ninux/emant/README.md

# emant
Elektromagnetische Felder und Antennen - HSLU T&amp;A
