ninux/emant/lab1/Laborbericht_1_Kusi/tex/title.tex

\begin{titlepage}
	\centering
	% left bottom right top
%	\includegraphics[trim = 20mm 100mm 20mm 20mm, clip, width = 50mm]{pic/title.jpg}\par\vspace{1cm} \nocite{wr}
	
	{\scshape\LARGE Hochschule Luzern \par}
	\vspace{0.75cm}
	{\scshape\Large EMANT Laborbericht 1\par}
	\vspace{1cm}
	{\huge\bfseries Monopol Antenne\par}
	\vspace{1.5cm}
	{\Large\itshape Markus Birrer\par}
	\vspace{0.5cm}
	
	\begin{figure}[htbp]
		\centering
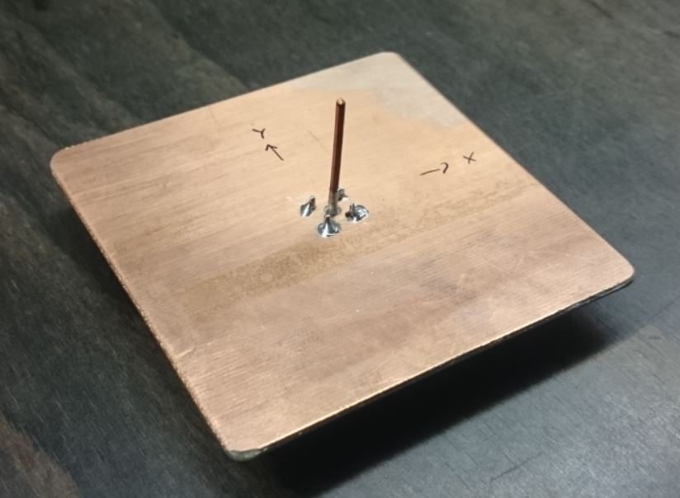
[picture p1: lab1/Laborbericht_1_Kusi/pic/Monopol_Antenne.JPG]
		
		\label{fig:MonopolAntenne}
	\end{figure}
	
		\vspace{0.5cm}
	
	{\Large\itshape Datum Messungen: 4.Mai 2017 \par}

	\vspace*{15 mm}
	\raggedright
	{\Large Selbstständigkeitserklärung} \\
	\vspace{0.5cm}
	Hiermit erkläre ich, dass ich die vorliegende Arbeit selbstständig angefertigt und keine anderen als die angegebenen Hilfsmittel verwendet habe. Sämtliche verwendeten Textauschnitte, Zitate oder Inhalte anderer Verfasser wurden ausdrücklich als solche gekennzeichnet. \\
	\vspace{1cm}
	{\large Horw, \today      \hspace{150pt} Unterschrift:}   

	%supervised by\par
	%Dr.~Mark \textsc{Brown}

	\vfill

% Bottom of the page
%	{\large \today\par}
\end{titlepage}

\newpage
