ninux/emant/lab2/fig/pic/mapping.md

# Mapping - Bild zu Messung

| Name  | Messung |
|---|---|
| d2_01 | blankes PCB mit SMA Stecker, Messkabel und angelötetem USB Stecker |
|  |  |
|  |  |
|  |  |
|  |  |
|  |  |
|  |  |
|  |  |
|  |  |
|  |  |
|  |  |
|  |  |
