ninux/emant/lab2/rep/gls/glossar.tex

\newglossaryentry{g_pwm} {
	name		= {PWM},
	description	= {Pulsweitenmodulation oder Pulsbreitenmodulation
		(engl. \emph{pulse-width modulation}) bezeichnet eine
		Modulationsart mit fester Frequenz und variabler
		Pusldauer}
}

\newglossaryentry{g_ppc} {
	name		= {Gegentaktwandler},
	description	= {Gegentaktwandler oder Gegentaktflusswandler
		(engl. \emph{push-pull converter}) bezeichnet eine
		Schaltung, welche zur Gleichspannungswandlung verwendet wird}
}

\newglossaryentry{g_psr_converter} {
	name		= {Phase-Shift Resonanzwandler},
	description	= {Phase-Shift Resonanzwandler oder Phase-Shift
		PWM Wandler (engl. \emph{phase-shifted full-bridge})
		bezeichnet eine spezielle Implementierung des
		Gegentaktwandlers}
}

\newglossaryentry{g_soft_switching} {
	name		= {weiches Schalten},
	description	= {Weiches Schalten bezeichnet den Schaltvorgang
		von Leistungshalbleitern, welcher durch kleine Schaltverluste
		gekennzeichnet ist}
}

\newglossaryentry{g_hard_switching} {
	name		= {hartes Schalten},
	description	= {Hartes Schalten bezeichnet den Schaltvorgang
		von Leistungshalbleitern, welcher durch hohe Schaltverluste
		gekennzeichnet ist}
}

\newglossaryentry{g_zvs} {
	name		= {Zero-Voltage Switching},
	description	= {Zero-Voltage Switching bezeichnet das
		Schalten von Leistungshalbleitern bei reduziertem
		Spannungabfall über dem Halbleiter. Dieses wird zur
		Reduktion von Schaltverlusten verwendet}
}

\newglossaryentry{g_zcs} {
	name		= {Zero-Current Switching},
	description	= {Zero-Current Switching bezeichnet das
		Schalten von Leistungshalbleitern bei reduziertem
		Strom durch den Halbleiter. Dieses wird zur
		Reduktion von Schaltverlusten verwendet}
}

\newglossaryentry{g_pwm_converter} {
	name		= {PWM Wandler},
	description	= {PWM Wandler oder auch PWM Gegentaktwandler
		bezeichnet einen Gleichspannungswandler, welcher die
		Pulsweitenmodulation verwendet}
}

\newglossaryentry{g_tina} {
	name		= {TINA},
	description	= {PSpice gestütztes Programm zur
		Schaltungssimulation von DesignSoft}
}

\newglossaryentry{g_matlab} {
	name		= {MATLAB},
	description	= {Programmiersprache und gleichnamies Programm
		zur numerischen Berechnung und Simulation von
		MathWorks}
}

\newglossaryentry{g_duty} {
	name		= {Tastgrad},
	description	= {Als Tastgrad (engl. \emph{duty-cycle}) wird die
		Aussteuerung bzw. der Modulationsgrad von
		verschiednenen Wandlungs- oder Modulationsverfahren
		bezeichnet}
}

\newglossaryentry{g_zk} {
	name		= {Zwischenkreis},
	description	= {Als Zwischenkreis bezeichnet man in der
		Leistungselektronik Energiespeicher, welche verschiedene
		Netze koppeln}
}

\newglossaryentry{g_wav} {
	name		= {Waveform Datei},
	description	= {Aus RIFF abgeleitetes Dateiformat für die
		Datenspeicherung (meist Audiodaten)}
}
