ninux/emant/lab2/rep/pkg/definitions.tex

% define plot parameters
\newcommand{\twopltvmin}{10.5}
\newcommand{\twopltvmax}{13.5}
\newcommand{\twopltcrmin}{0.00}
\newcommand{\twopltcrmax}{1.20}
\newcommand{\twopltsocmin}{-5}
\newcommand{\twopltsocmax}{105}
\newcommand{\twopltdvmin}{0.05}
\newcommand{\twopltdvmax}{0.65}

% define schematic parametery
\newcommand{\schematicscale}{0.5}
