ninux/emant/lab2/rep/tex/discussion/discussion.tex

\section{Fazit $\&$ Diskussion}
Der Vergleich zwischen Simulationen und Messungen zeigten Übereinstimmungen. Wir waren in der Lage eine Antenne zu entwickeln und zu bauen, welche die gewünschten Anforderungen erfüllt. Das besonders gute Ergebnis beim Reflexionskoeffizient bei 2.4 GHz war ein Glücksfall.
