ninux/emant/lab2/rep/tex/title/title.tex

\thispagestyle{empty}
\begin{titlepage}

\begin{center}

% Oberer Teil der Titelseite:
%\includegraphics[width=0.15\textwidth]{./logo}\\[1cm]    
\textsc{
	\LARGE Hochschule Luzern\\~\\Technik \& Architektur}\\[1.5cm]
\vfill{}
\large EMANT
\\[0.5cm]
% Title
\newcommand{\HRule}{\rule{\linewidth}{0.5mm}}
\HRule
\\[0.4cm]
{
	%\Huge \bfseries Industrieprojekt\\
        %~\\
        %\large Aufbau eines 800W Phase-Shift Resonanzwandlers}\\[0.4cm]

	\Huge \bfseries Design Report Laborübung 2\\
        ~\\
        \large Entwicklung einer WLAN\texttrademark  Planarantenne}
\\[0.4cm]
\HRule
\\[0.5cm]

%	\large zur Erlangung des Testats \\
%		zur Modulendprüfung des Moduls \\
%		Elektromagnetische Felder und Antennen

\vfill{}

% Author and supervisor
\begin{minipage}{0.4\textwidth}
    \begin{flushleft} \large
	\emph{Autoren}\\
        Ervin Mazlagi\'c\\
        Markus Birrer\\ ~ \\
	\emph{Eingabe der Arbeit}\\
	Horw, \today
    \end{flushleft}
\end{minipage}
\hfill
\begin{minipage}{0.4\textwidth}
    \begin{flushright} \large
        \emph{Dozent} \\
        Joss Marcel
    \end{flushright}
\end{minipage}

%\vfill{}

% Unterer Teil der Seite
%{
%	%\large Altishofen\\ \today
%	Horw\\ 23. Dezember 2016
%}

%\begin{minipage}{0.4\textwidth}
%	\begin{flushleft}
%		\emph{Geheimhaltungsstufe}
%		Rücksprache
%	\end{flushleft}
%\end{minipage}
%\hfill
%\begin{minipage}{0.4\textwidth}
%	\begin{flushright}
%		Horw\\ 23. Dezember 2016
%	\end{flushright}
%\end{minipage}

\end{center}

\end{titlepage}
