ninux/emant/lab2/rep/tex/README.md

# tex - LaTeX Dokumente
---

* Titelseite			(title/title.tex)
* Selbstständigkeitserklärung	(declaration/declaration.tex)
* Abstract			(abstract/abstract.tex)
* Inhaltsverzeichnis		(-)
* Glossar			(glossary/glossary.tex)

## Teil I - Einführung		(introduction/)
* Applikation			(application.tex)
* Problemstellung		(problem.tex)
* Aufgabenstellung		(mission.tex)

## Teil II - Theorie		(theory/)
* Verluste von MOSFET-Schaltern (losses.tex)
* Phasenverschiebungsmodulation (psm.tex)

## Teil III - Simulation	(simulation/)
* Simulationsmodelle		(models.tex)
* Messungen			(measurements.tex)
* Modulator			(modulator.tex)
* Ergebnisse			(results.tex)

## Teil III - Funktionsmuster	(experimental/)	
* Controller Evaluation		(evaluation.tex)
* Simulation			(simulation.tex)
* Funktionsmuster		(model.tex)
* Ergebnisse			(results.tex)

## Teil IV - Prototyp		(prototype/)

## Teil V - Vergleich		(comparison/)

## Listen & Anhänge	
* Literaturverzeichnis		(-)
* Abbildungsverzeichnis		(-)
* Tabellenverzeichnis		(-)
* Anhang			(appendix/appendix.tex)
