ninux/emant/lab1/Laborbericht_1_Kusi/main.tex

\documentclass[a4paper,10pt,fleqn]{article}
\usepackage{tex/layout}

\usepackage{hyperref}
\usepackage{url}

\begin{document}

\input{tex/title}

\newpage
%\input{tex/Selbststaendigkeitserklaerung}

% Inhaltsverzeichniss
\input{tex/table}

%\input{tex/aufgabenstellung}
\input{tex/text}

\vspace{30mm}
% \phantomsection
%\addcontentsline{toc}{section}{\listfigurename}
\listoffigures

%\newpage
%\bibliographystyle{plain}
%\bibliography{tex/bibliographie}
%\nocite{dsvb_script}
\nocite{*}
       
\end{document}
