ninux/emant/lab2/rep/tex/calculation/calculation.tex

\section{Berechnungen}

\begin{figure}[h!]
	\centering
	
	\caption{Link-Budget und weitere Berechnungen}
\end{figure}
