ninux/emant/lab1/Laborbericht_1_Kusi/Sonstige Doks/Analyse Bilder.pptx

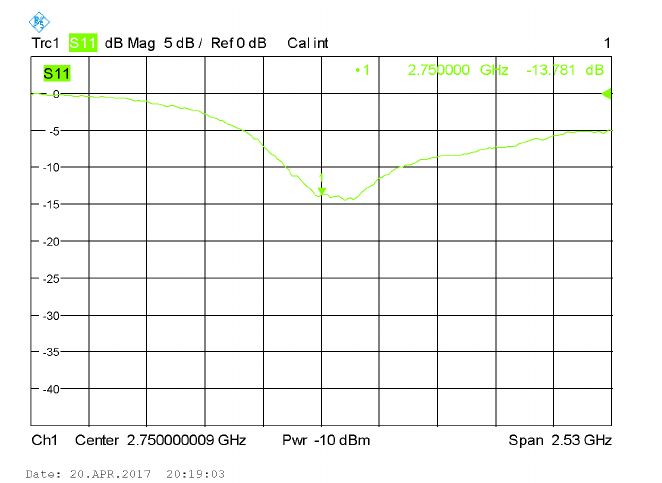
[picture p32: figure]

2.5GHz

3GHz

2.875GHz
