ninux/emant/lab1/Laborbericht_1_Kusi/Laborbericht _1_Markus_Birrer.pdf

Hochschule Luzern

EMANT Laborbericht 1

# Monopol Antenne

## Markus Birrer

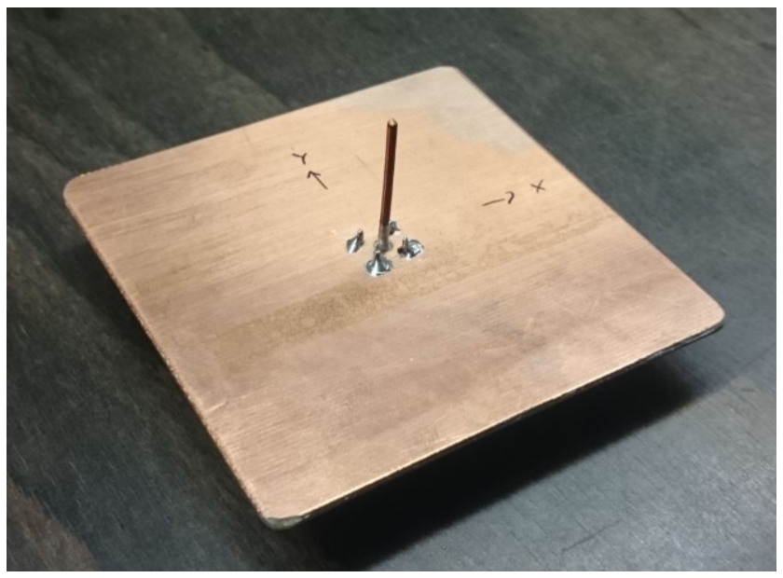
[picture p33: figure]

## Datum Messungen: 4.Mai 2017

## Selbstständigkeitserklärung

Hiermit erkläre ich, dass ich die vorliegende Arbeit selbstständig angefertigt und keine anderen als die angegebenen Hilfsmittel verwendet habe. Sämtliche verwendeten Textauschnitte, Zitate oder Inhalte anderer Verfasser wurden ausdrücklich als solche gekennzeichnet.

Horw, 19. Mai 2017 | Unterschrift:

EMANT | Hochschule Luzern - Technik & Architektur | Markus Birrer

## Inhaltsverzeichnis

1 Zusammenfassung | | 1
2 Einführung | | 2
3 Experimentelles | 3
4 Resultate | 7
5 Diskussion/Analyse | 9

## 1 Zusammenfassung

Dieser Bericht behandelt das Entwickeln, Simulieren und Ausmessen einer Monopolantenne. Zweck der Aufgabenstellung war Erfahrungen in der Handhabung der verschiedenen Tools zu gewinnen. Dazu gehört die Simulationssoftware EMPIRE, das Kalibrieren und Messen mit dem Netzwerkanalyser und das Ausmessen mit dem Linear Scanner.
Die Designfrequenz der Monopolantenne beträgt 2.75 GHz. Mittels der Simulationsoftware EMPIRE wurde das mechanische Design so verändert, dass die Parameter die gewünschten Anforderungen erfüllen. Insbesondere der Reflexionskoeffizient S11 sollte bei der Designfrequenz einen möglichst tiefen Wert erreichen.
Nach der Produktion wurde die Antenne als erstes mit dem Netzwerkanalyzer ausgemessen. Die Antenne zeigte ansatzweise das gewünschte Verhalten. Die effektive Resonanzfrequenz lag leicht höher als die Designfrequenz Der Reflexionskoeffizient S11 war nicht ganz so ausgeprägt wie simuliert. Durch mechanische Bearbeitung (abschneiden) konnte die Resonanzfreqquenz der Designfrequenz angenähert werden.
Zum Abschluss wurde noch die Abstrahlcharakteristik der Antenne ausgemessen. Dabei zeigte die Antenne das erwartete Verhalten in der Form eines Apfels.
19. Mai 2017 | 1

EMANT | Hochschule Luzern - Technik & Architektur | Markus Birrer

## 2 Einführung

### 2.1 Designfrequenz

Es wurde eine Designfrequenz von 2.75GHz gewählt.

### 2.2 Berechnungen

Die Designfrequenz war die Basis für Berechnungen zur Länge der Monopolantenne und zur Grösse der Platine. Diese Werte wurden Mithilfe von Excel berechnet:

Wellenlänge:

λ =

c
f = 109 mm

λ
4 = 27.2 mm

Aussenmasse der Platine: Bei den Aussenmassen der Platine ist ein Fehler unterlaufen. Gemäss Aufgabenstellung sollte die Diagonale der GND-Plane √

λ
2

betragen. Dies entspricht bei der gewählten Designfrequenz 77 mm. Aus Versehen wurde eine Kantenlänge von 77 mm gewählt.

### 2.3 Koordinatensystem

Um sich besser zurechtzufinden, ist hier nochmals das Koordnatensystem mit den Winkel abgebildet. [Joss.M, 2017, Elektromagnetische Felder und Antennen, Seite 8]


Abbildung 1: Koordinatensysteme

19. Mai 2017 | 2

EMANT | Hochschule Luzern - Technik & Architektur | Markus Birrer

## 3 Experimentelles

### 3.1 Verwendete Messgeräte

Messgerät | Hersteller | Inventarnr.
Netzwerkanalyzer | Rohde & Schwarz | 342
Linear Scanner | Starlab | ??

Tabelle 1: Liste mit den verwendeten Messgeräten

### 3.2 Simulation

### 3.2.1 Vorbereitung zur Simulation

Vor der eigentlichen Simulation wurde die Monopolantenne im Simulationstool gezeichnet. Die Monopolantenne besteht aus den drei Komponenten:

- Groundplane
- Monopol
- Source

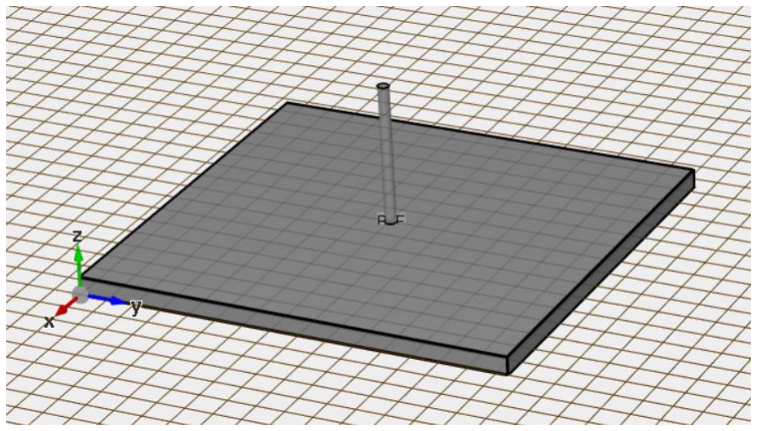
[picture p34: figure]

Abbildung 2: 3D-Darstellung der Platine

19. Mai 2017 | 3

EMANT | Hochschule Luzern - Technik & Architektur | Markus Birrer

### 3.2.2 Simulationsergebnisse

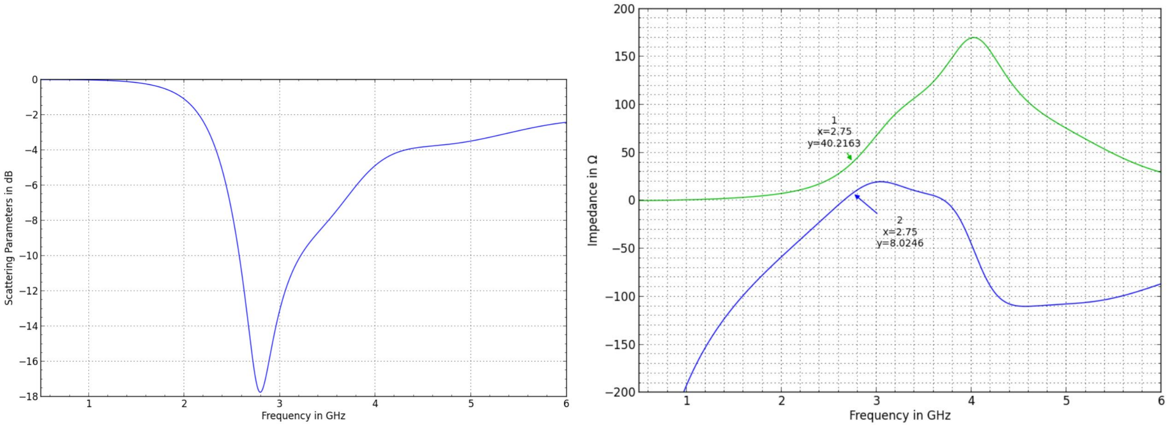
[picture p35: figure]

(a) Reflexionskoeffizient S11 | (b) Impedanz Z (grün: Real(Z), blau: Imag (Z)

Abbildung 3: Simulation der Parameter

Auf Abbildung 3a ist ersichtlich, dass der tiefste Reflexionskoeffizient des Designs bei ca. 2.8 GHz liegt. Abbildung 3b zeigt den Realanteil und Imaginäranteil der Impedanz bei der Designfrequenz von 2.75GHz. Der Realanteil beträgt ca. 40 Ω statt den gewünschten 50 Ω. Der Imaginäranteil beträgt 8 Ω statt 0 Ω. Mit der Kenntnis der entstehenden Impedanz könnte das Design optimiert werden. Dies war in der Aufgabenstellung nicht gefordert und wurde dementsprechend unterlassen.

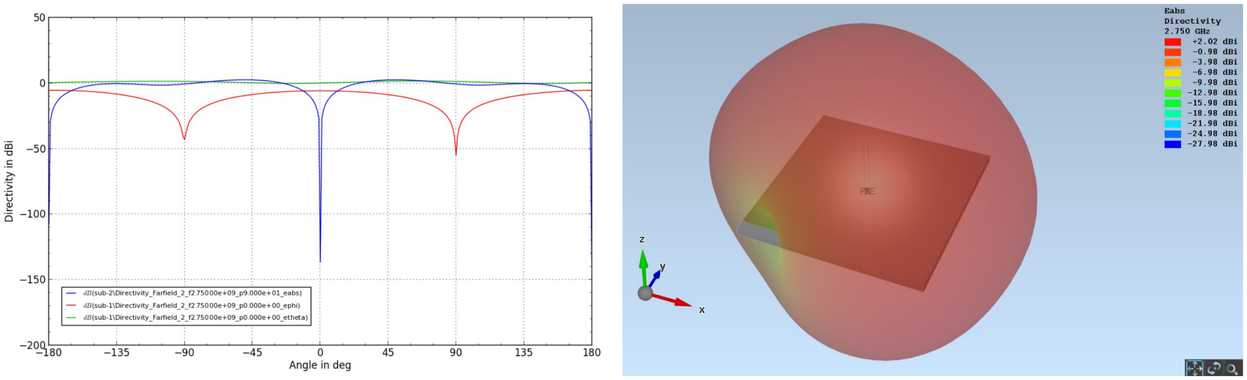
[picture p36: figure]

(a) Fernfeld im Diagramm | (b) Fernfeld graphisch

Abbildung 4: Fernfeld-Simulationen

Abbildung 4 zeigt die graphische Simulation des Fernfeldes. Die dargestellte Grafik zeigt nicht das gewünschte Verhalten. Die Punkte mit schwachem Feld sollten oberhalb und unterhalb des Monopols liegen. Stattdessen liegen sie in der horizontalen Ebene. Die Ursache für die fehlerhafte Darstellung konnte nicht gefunden werden. Sehr wahrscheinlich liegt es an einer inkorrekten Einstellung im Simulationsprogramm.

19. Mai 2017 | 4

EMANT | Hochschule Luzern - Technik & Architektur | Markus Birrer

### 3.3 Versuchsablauf

Nachfolgend ist beschrieben wie die Messungen durchgeführt werden.

### 3.3.1 Netzwerkanalyser

Kalibrierung Vor der eigentlichen Messung gilt es den Netzwerkanalyser zu kalibrieren. Dafür gibt es spezielle Messwiderstände. Im Umgang mit den Koaxialkabeln gilt es zu beachten, dass diese möglichst wenig gebogen werden. Auch müssen die Kabel mit einem bestimmten Drehmoment angeschlossen werden. Dazu steht ein spezieller Drehmomentschlüssel zur Verfügung. Das Kabel und die Widerstände sollen so platziert werden, dass sie eine gewisse Distanz zu anderen Gegenständen aufweisen.
Der Netzwerkanalyser verfügt über ein Menü (Taste CAL), welches den Anwender durch den Kalibrierungsprozess führt.

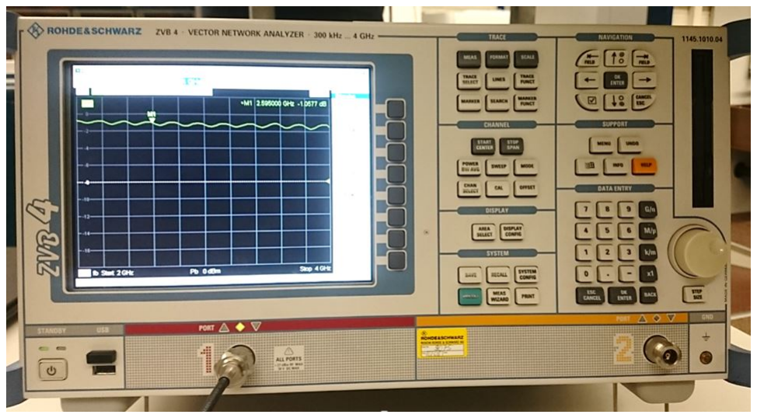
[picture p37: figure]

Abbildung 5: Netzwerkanalyzer

Return-Loss-Messung
Nach dem Kalibrieren geht es darum die eigentliche Messung durchzuführen. Dazu wird die Monopolantenne ans Kabel angeschlossen. Über die Tasten PRES, MEAS gelangt man in das richtige Menü. Es handelt sich um eine Return-Loss Messung (S11). Bevor das/die Bilder der Messung exportiert werden, empfiehlt es sich einen oder mehrere Marker zu setzen.
19. Mai 2017 | 5

EMANT | Hochschule Luzern - Technik & Architektur | Markus Birrer

### 3.3.2 Linear Scanner

Mit dem Linear Scanner von StarLab kann die Richtstrahlcharakteristik von Antennen bestimmt werden. Es ist empfohlen vor dem Montieren des Testprints die Achsen zu markieren (Beispiel; siehe Titelbild). Wenn man vor dem Starlab steht, zeigt die x-Achse nach rechts und die y-Achse nach hinten (ins Gerät hinein). Nach dem Montieren des Testprints kann die Messöffnung mit den beiden mobilen Stellwänden verschlossen werden.


Abbildung 6: Linear Scanner von Starlab

Auf dem BedienPC werden zwei Programme benötigt. Zum einen das Programm SPM, mit welchem die eigentliche Messung durchgeführt wird. Zum anderen das Programm SatEnv, welches die Datenauswertung vornimmt. Nach der Messung können die Daten vom SPM in ein neues Projekt des SatEnv exportiert werden. Betreffend dem Vorgehen der Datenauswertung im SatEnv liegt eine detaillierte Bedienungsanleitung vor.

19. Mai 2017 | 6

EMANT | Hochschule Luzern - Technik & Architektur | Markus Birrer

## 4 Resultate

### 4.1 Messung mit dem Netzwerkanalyser

Bei der Messung des Reflektionskoeffizienten (S11) wurde der tiefste Wert bei einer Frequenz unterhalb von der Designfrequenz 2.75 GHz erreicht. Durch manuelles Verkürzen des Monopols in mehreren Schritten konnte die Frequenz erhöht werden. Es wurde schlussendlich ein bisschen zu viel abgeschnitten, die Antenne ist ein bisschen zu kurz geraten. Die geringste Reflexion wird bei ca. 2.875 GHz erreicht.
Der S11-Wert von -13.8dB ist nicht enorm gut, aber doch respektabel für einen ersten Entwurf.


Abbildung 7: Messung des Reflexionskoeffizienten S11

19. Mai 2017 | 7

EMANT | Hochschule Luzern - Technik & Architektur | Markus Birrer

### 4.2 Messung mit dem Linearscanner

Es wurde die Messung bei der Frequenz von 2.85 GHz ausgewertet. Dies weil die Messung mit dem Netzwerkanalyzer bei dieser Frequenz den geringsten Reflektionsfaktor zeigte.
Das Resultat entspricht den Erwartungen. Die 3D-Grafik zeigt eine ”apfelförmige” Abstrahlcharakteristik.

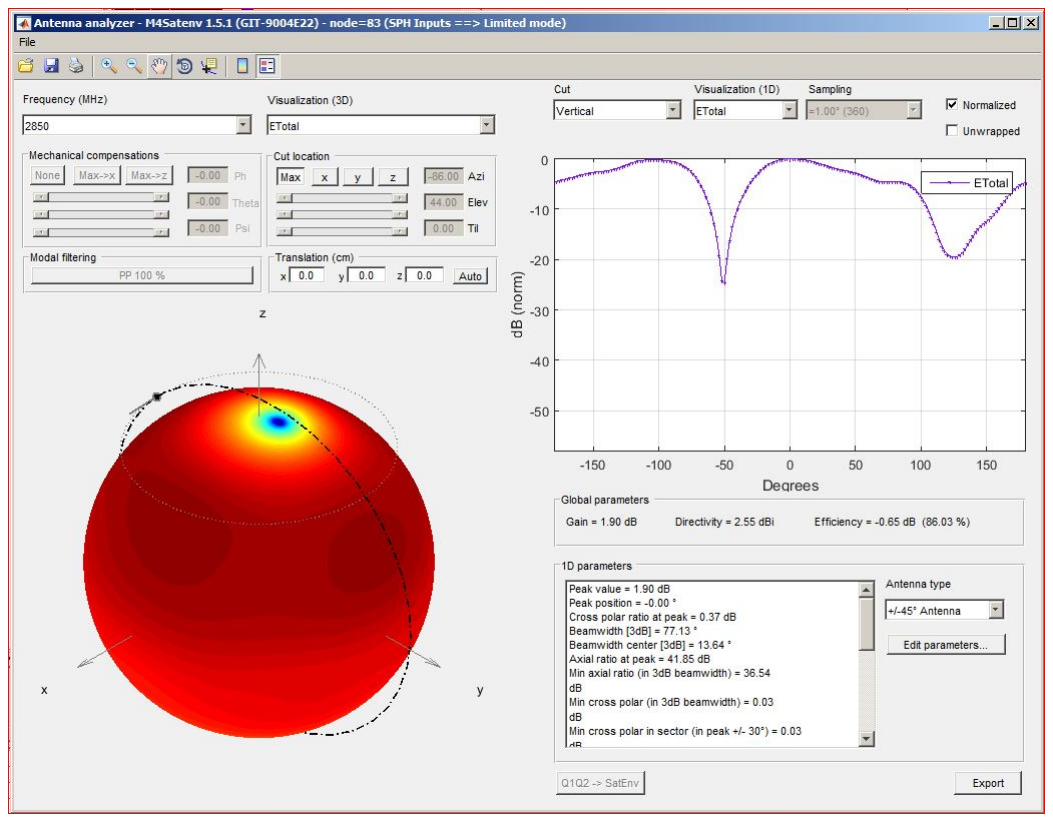
[picture p38: figure]

(a) Fernfeld geschnitten in der xz-Ebene (φ = 0°) | (b) Fernfeld graphisch

Abbildung 8: Fernfeld Messungen

Der maximale Antennengewinn beträgt 1.9dB beim Punkt mit den Winkeln φ = 0° und θ ca. 45°

19. Mai 2017 | 8

EMANT | Hochschule Luzern - Technik & Architektur | Markus Birrer

## 5 Diskussion/Analyse

Es konnte eine Monopol-Antenne produziert werden, welche das klassische Verhalten einer Monopol-Antenne zeigt. Die Performance der Antenne ist nicht sonderlich gut, aber liegt in der Toleranz für einen ersten Entwurf. Die Schwierigkeiten lagen in der Bedienung der Simulationssoftware EMPIRE und der Datenauswertung im Starlab. Gerade im Starlab steht man unter Zeitdruck, da nur Messgerät zur Verfügung steht.
Trotz der Schwierigkeiten, konnten Erfahrungen im Umgang mit der Simulationssoftware und den Messgeräten gesammelt werden.

## Abbildungsverzeichnis

1 | Koordinatensysteme | | 2
2 | 3D-Darstellung der Platine | | 3
3 | Simulation der Parameter | | 4
4 | Fernfeld-Simulationen | | 4
5 | Netzwerkanalyzer | | 5
6 | Linear Scanner von Starlab | | 6
7 | Messung des Reflexionskoeffizienten S11 | | 7
8 | Fernfeld Messungen | | 8
19. Mai 2017 | 9
