ninux/emant/lab1/Laborbericht_1_Kusi/pic/Messungen/Rigi Hochflue.JPG

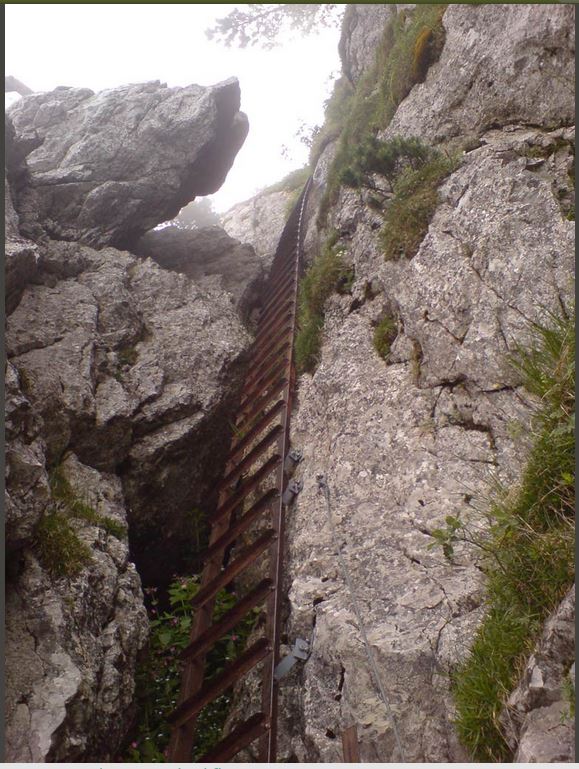
lab1/Laborbericht_1_Kusi/pic/Messungen/Rigi Hochflue.JPG
