ninux/emant/lab1/Laborbericht_1_Kusi/Sonstige Doks/DSC_1302.JPG

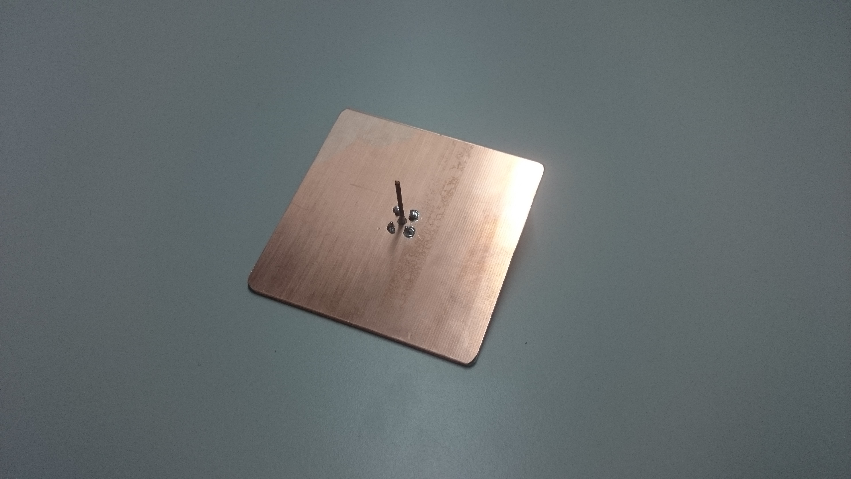
lab1/Laborbericht_1_Kusi/Sonstige Doks/DSC_1302.JPG
