ninux/emant/lab1/Laborbericht_1_Kusi/Sonstige Doks/DSC_1329.JPG

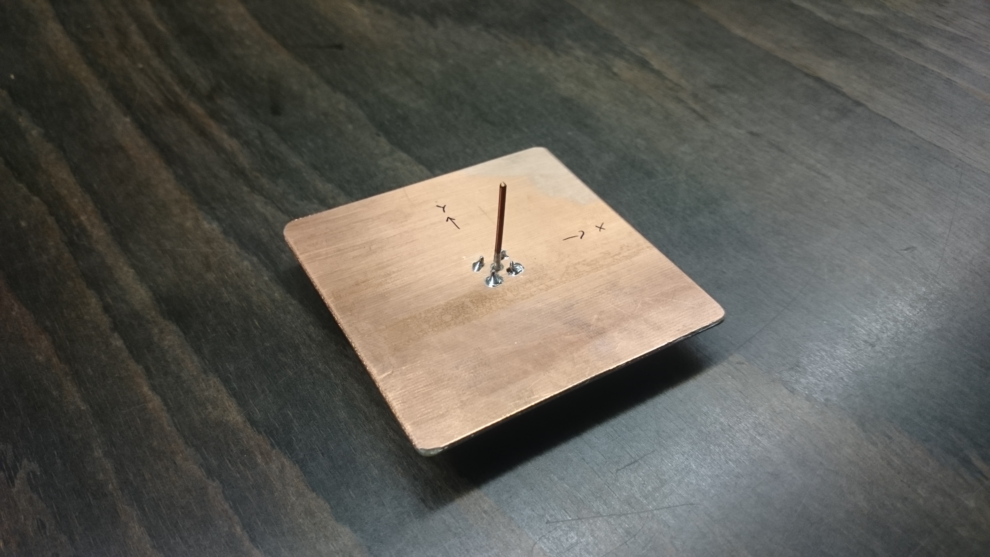
lab1/Laborbericht_1_Kusi/Sonstige Doks/DSC_1329.JPG
