ninux/emant/lab1/Laborbericht_1_Kusi/Sonstige Doks/Messung_S11.PNG

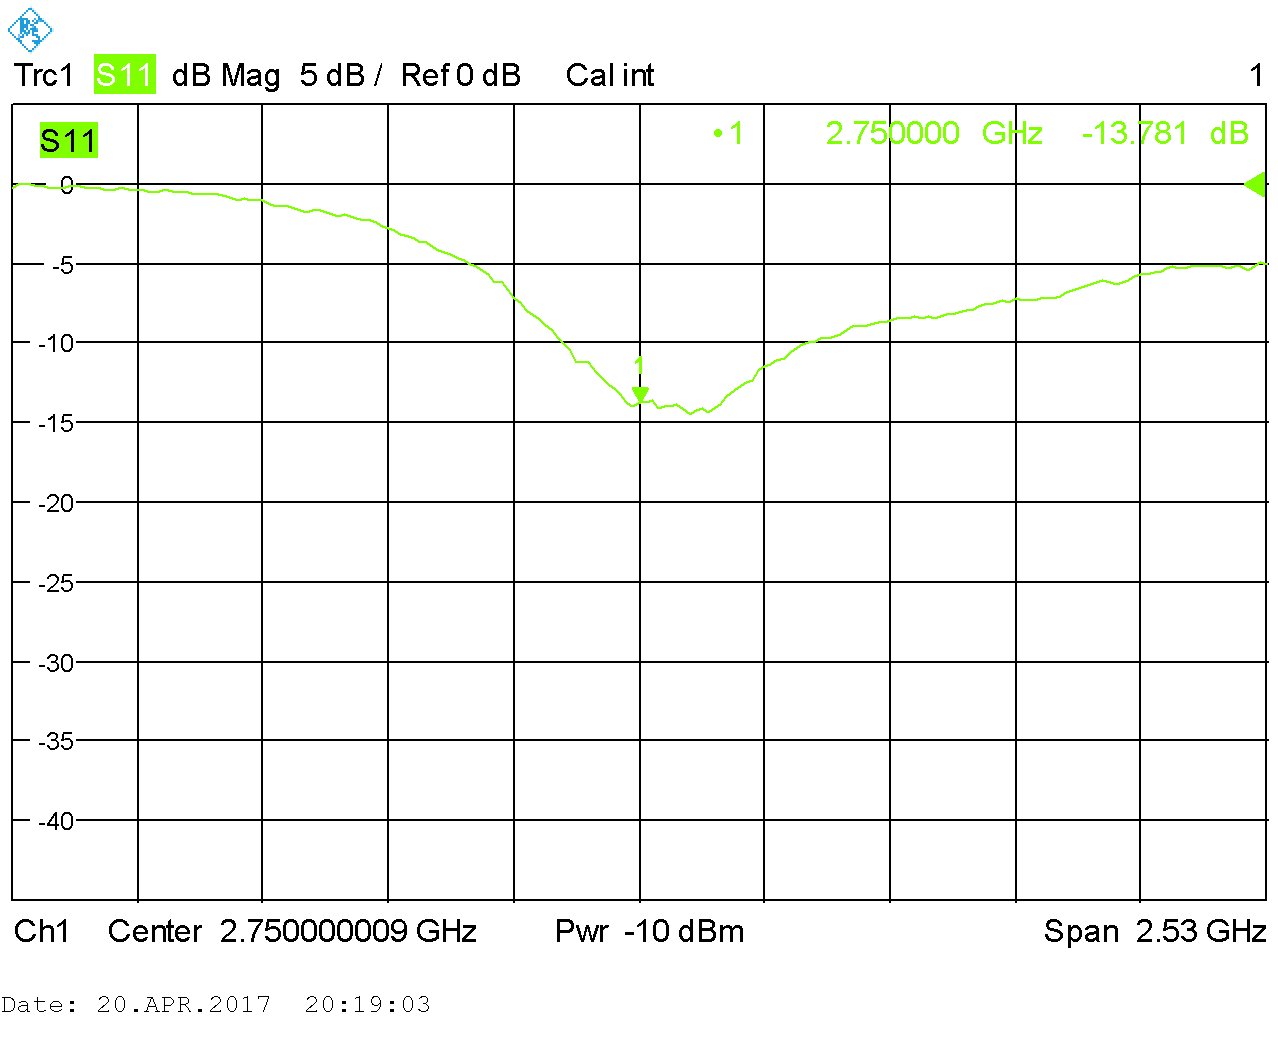
lab1/Laborbericht_1_Kusi/Sonstige Doks/Messung_S11.PNG
