ninux/emant/lab1/ninux/fig/plt/monopol_a_sim_3d_ephi.png

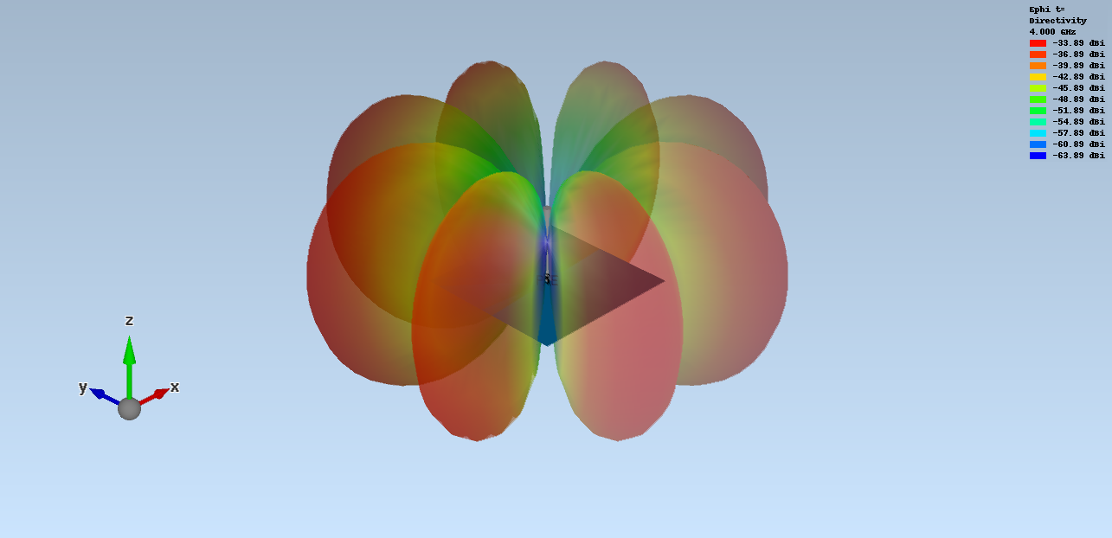
lab1/ninux/fig/plt/monopol_a_sim_3d_ephi.png
