ninux/emant/lab1/ninux/fig/plt/monopol_a_sim_3d_etheta.png

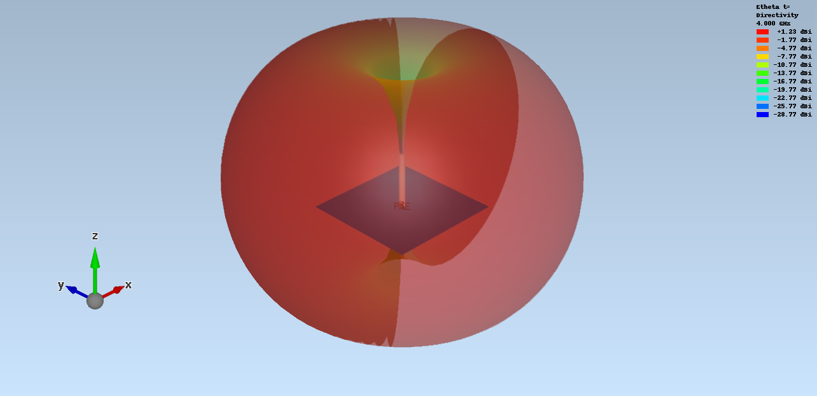
lab1/ninux/fig/plt/monopol_a_sim_3d_etheta.png
