ninux/emant/lab1/ninux/fig/plt/monopol_a_sim_3d_pattern.png

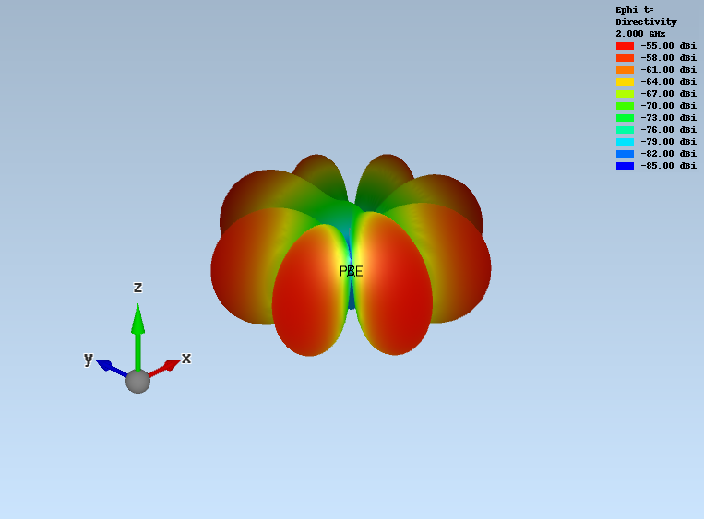
lab1/ninux/fig/plt/monopol_a_sim_3d_pattern.png
