ninux/emant/lab2/bilder_StarLab/StarLab_Etot/2.4GHz_sphere.JPG

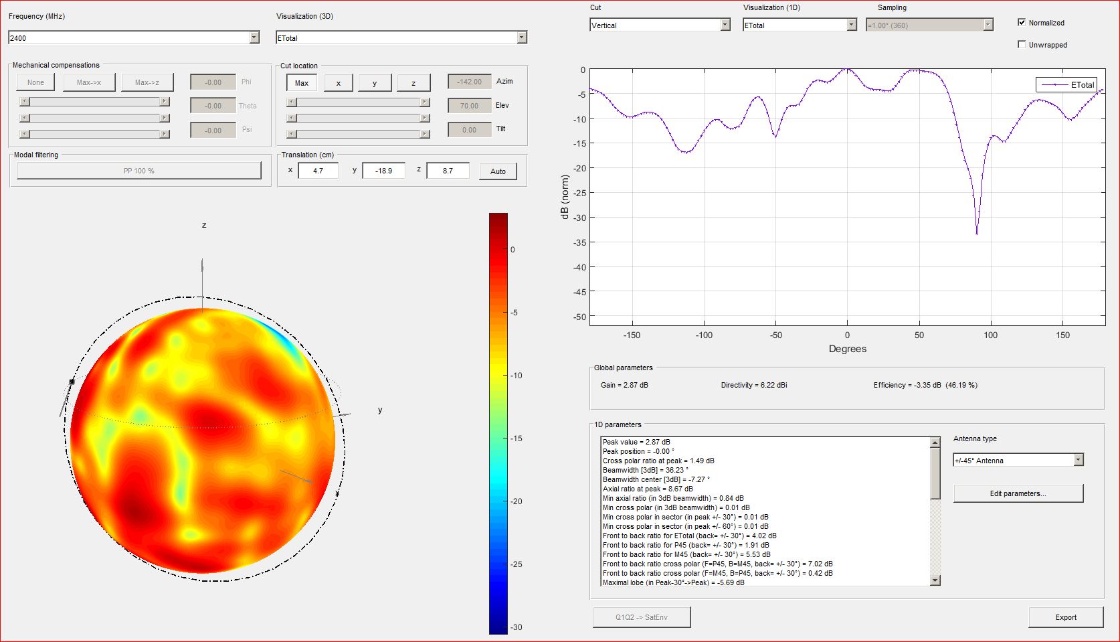
lab2/bilder_StarLab/StarLab_Etot/2.4GHz_sphere.JPG
