ninux/emant/lab2/bilder_StarLab/StarLab_Etot/2.4GHz_sphere_xz.JPG

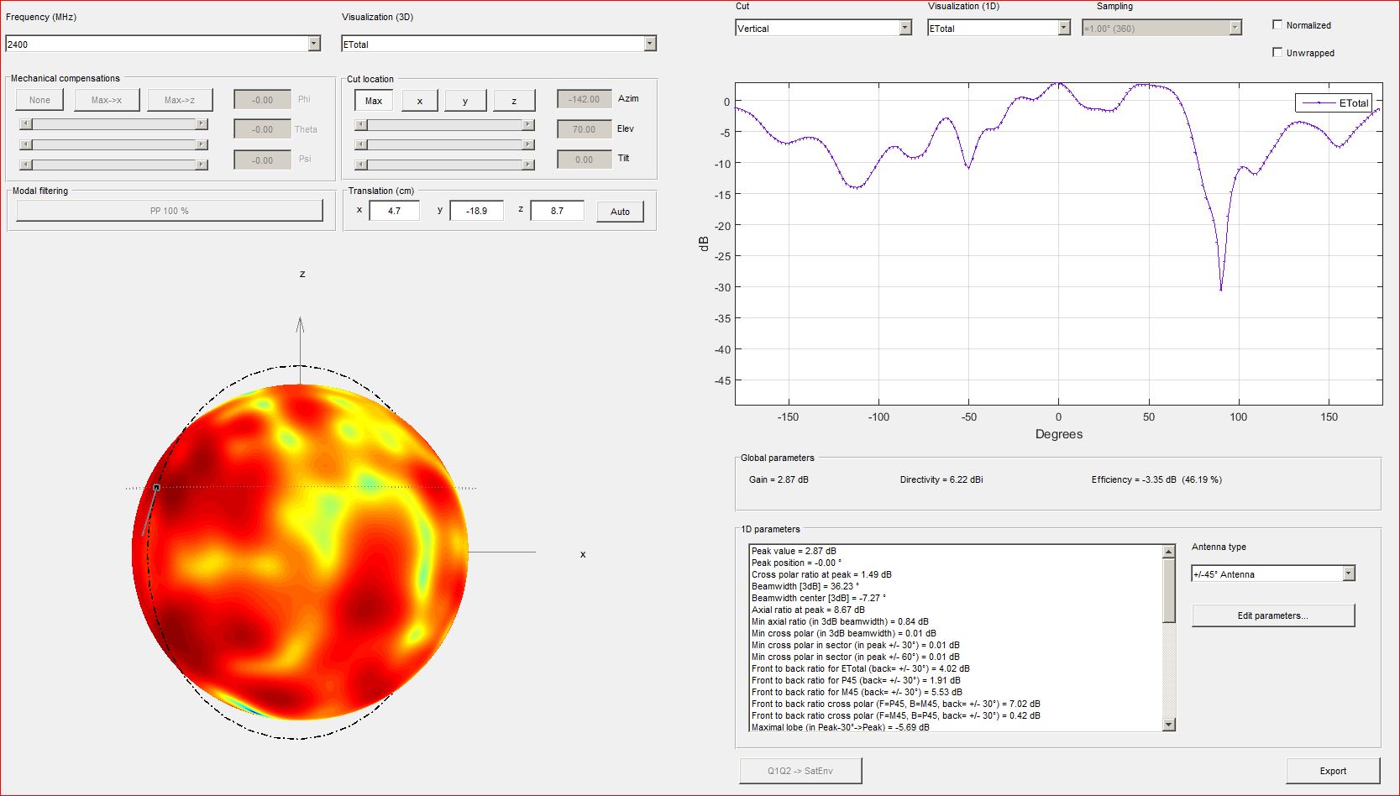
lab2/bilder_StarLab/StarLab_Etot/2.4GHz_sphere_xz.JPG
