ninux/emant/lab2/bilder_StarLab/StarLab_Etot/5GHz_sphere_xz.JPG

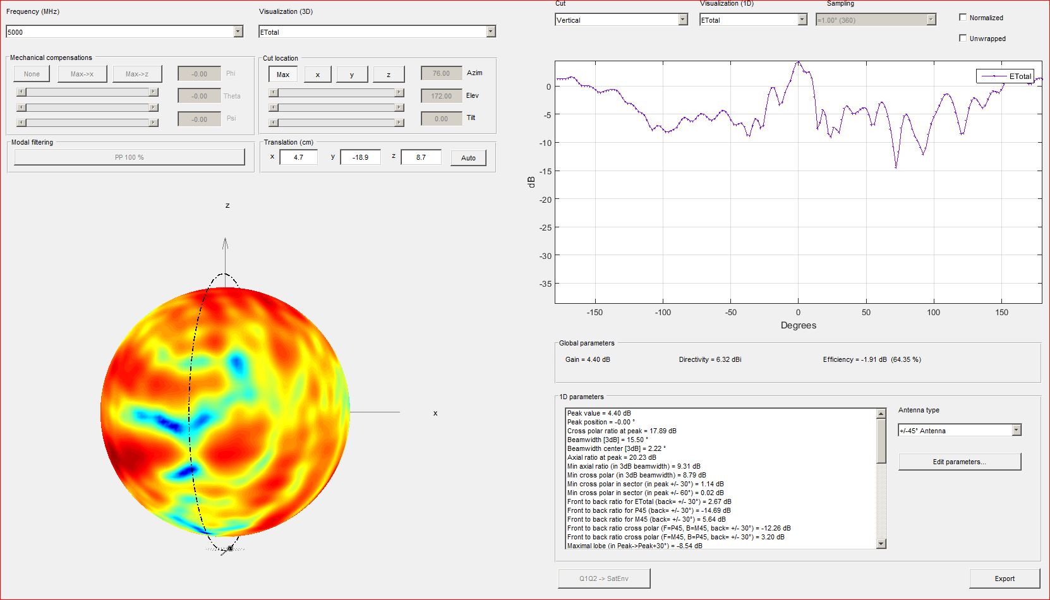
lab2/bilder_StarLab/StarLab_Etot/5GHz_sphere_xz.JPG
