ninux/emant/lab2/fig/not_used/crazy_stuff_l4_pcb_v2c_laptop_1a_105_2_4G_etot_phi90_1D.png

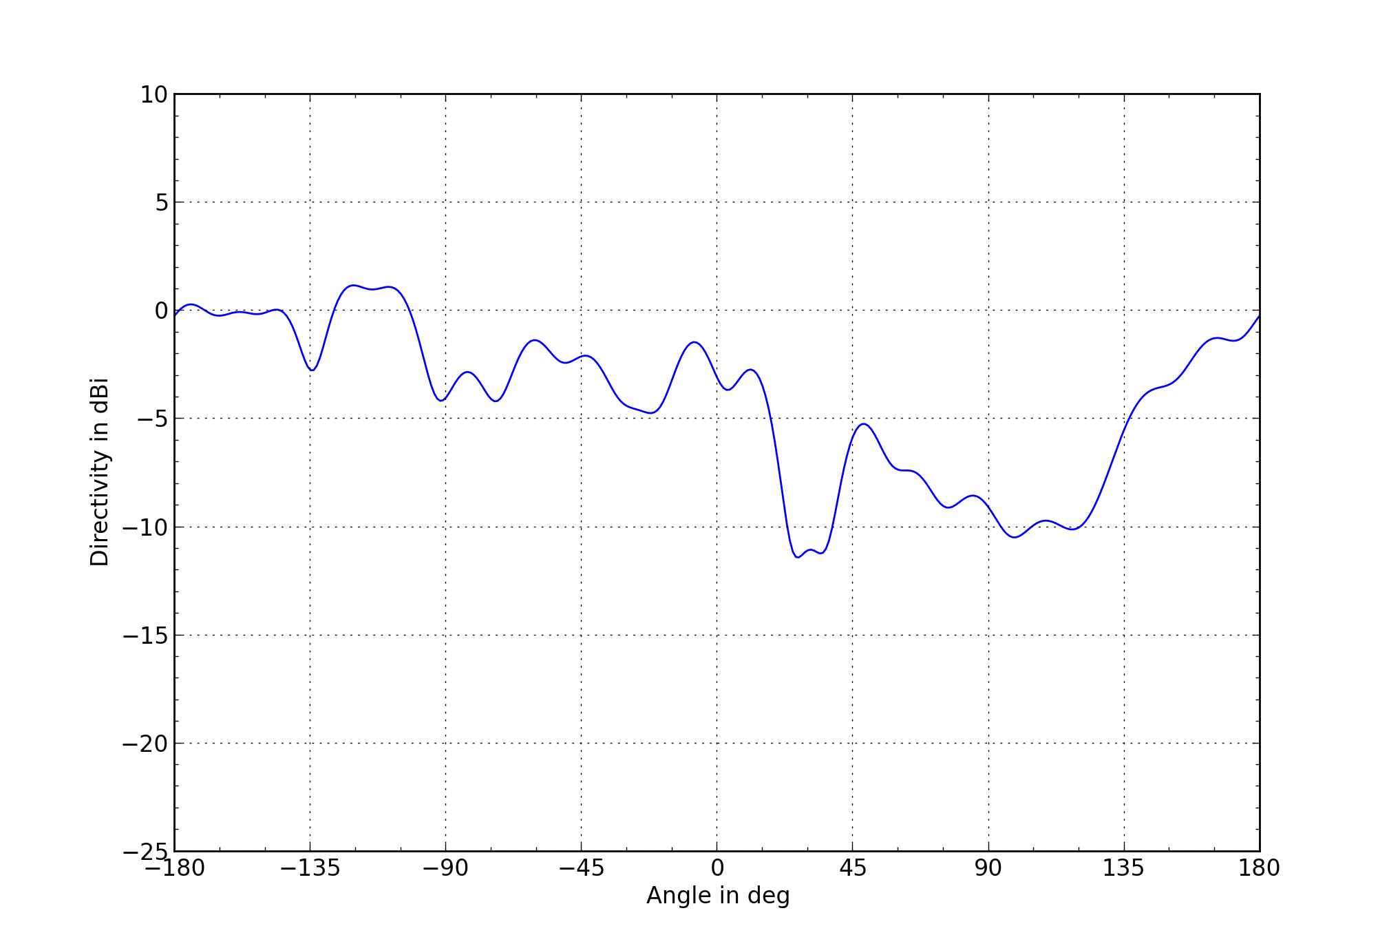
lab2/fig/not_used/crazy_stuff_l4_pcb_v2c_laptop_1a_105_2_4G_etot_phi90_1D.png
