ninux/emant/lab2/fig/not_used/crazy_stuff_l4_pcb_v2c_laptop_1a_105_2ghz4_3d_current_density_xy.png

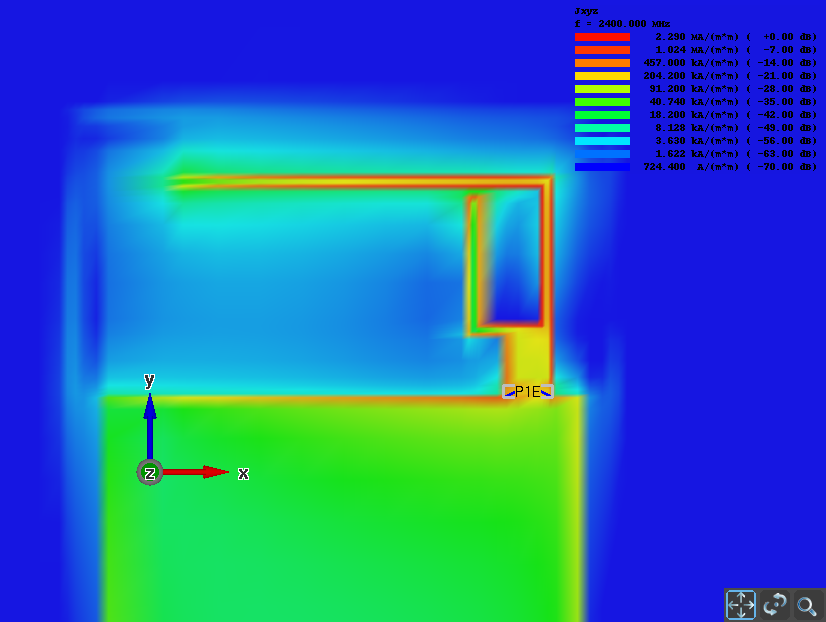
lab2/fig/not_used/crazy_stuff_l4_pcb_v2c_laptop_1a_105_2ghz4_3d_current_density_xy.png
