ninux/emant/lab2/fig/not_used/IMP_WITHOUT_2.4.PNG

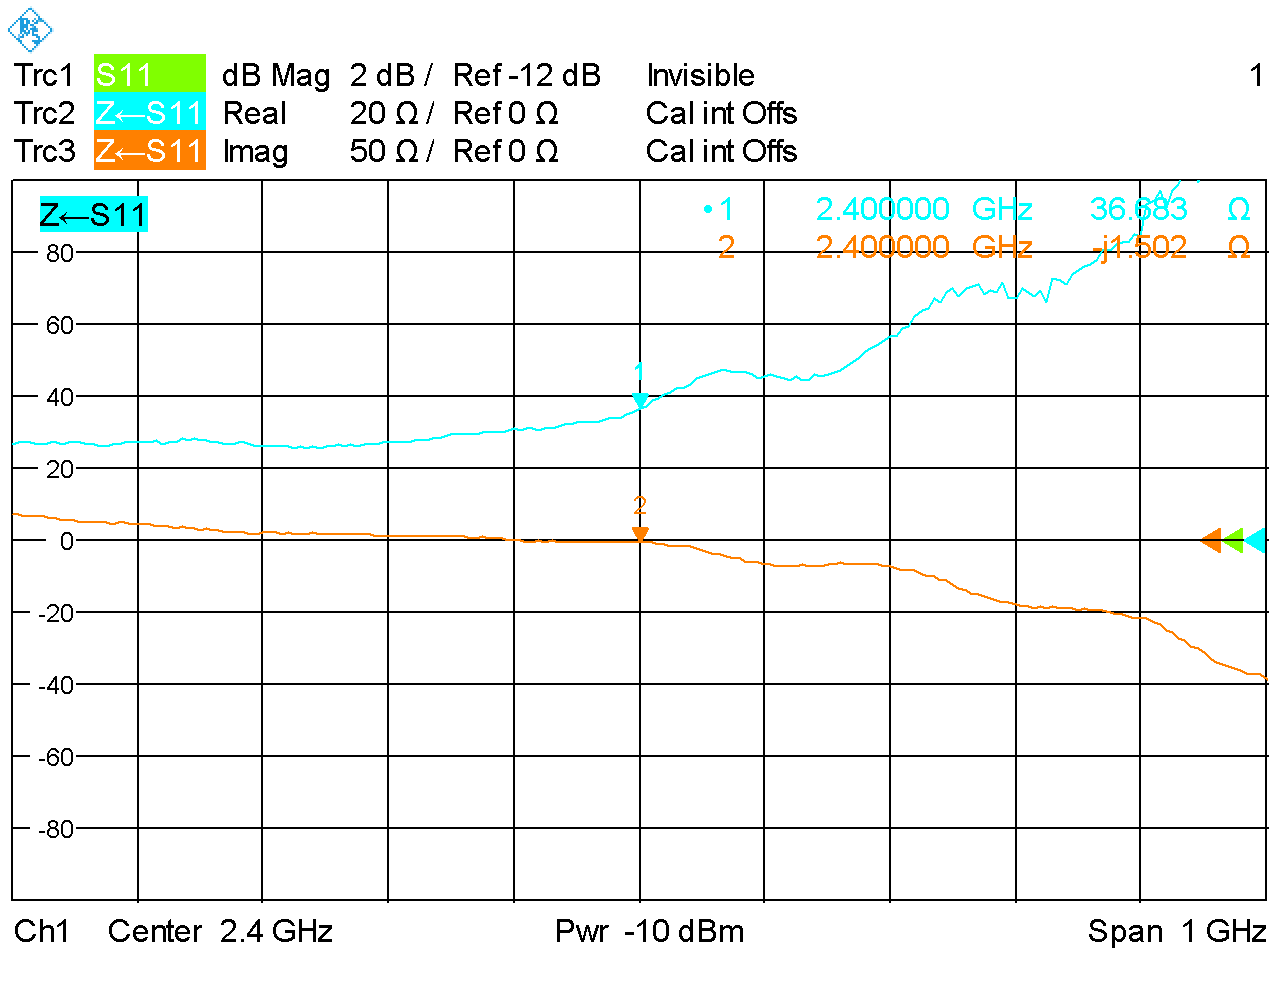
lab2/fig/not_used/IMP_WITHOUT_2.4.PNG
