ninux/emant/lab2/fig/not_used/IMP_WITHOUT_5.0.PNG

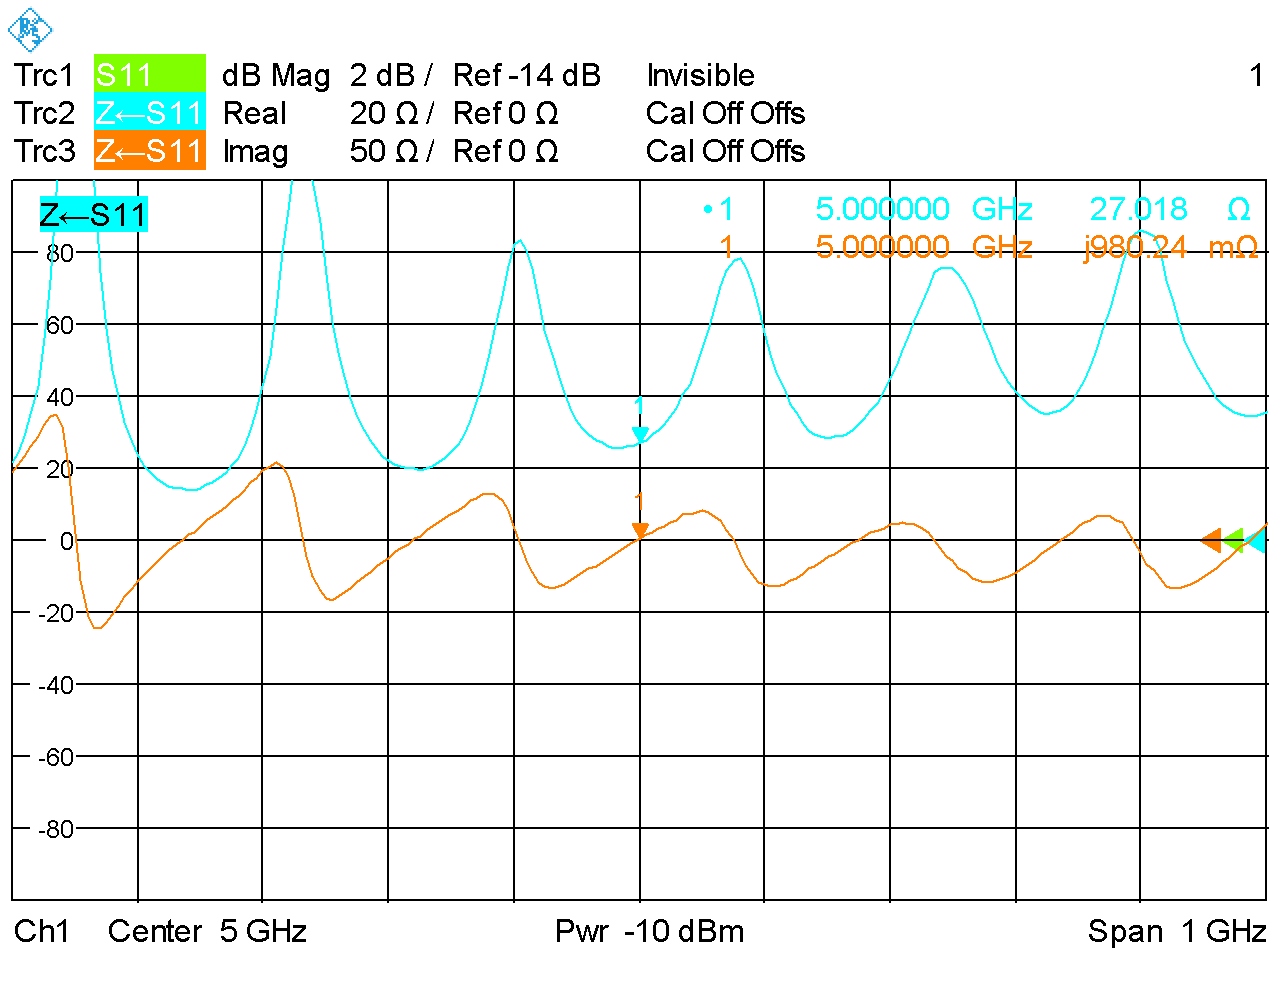
lab2/fig/not_used/IMP_WITHOUT_5.0.PNG
