ninux/emant/lab2/fig/not_used/IMP_WITHOUT_FULL.PNG

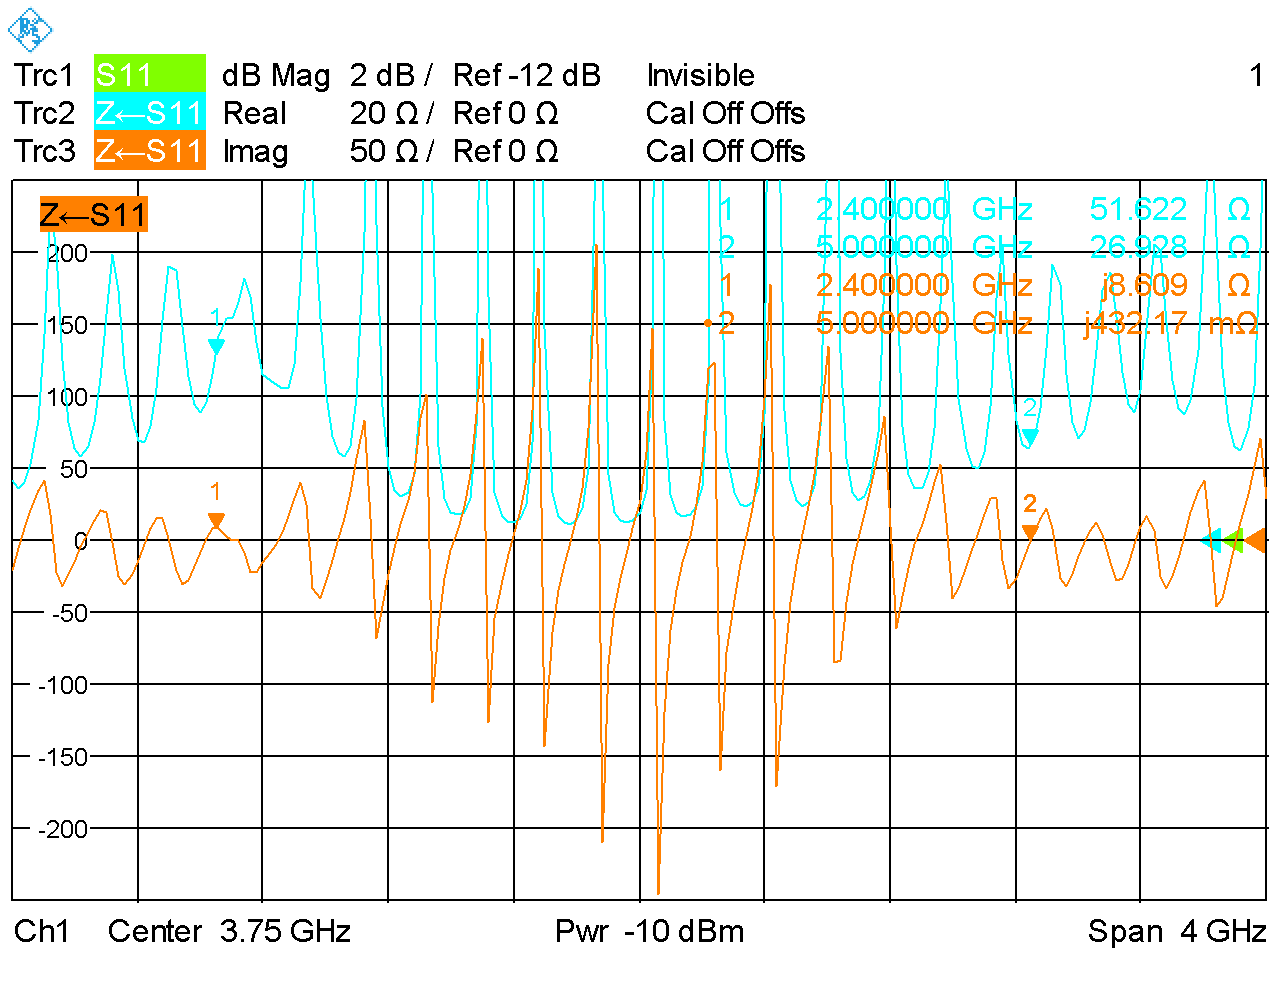
lab2/fig/not_used/IMP_WITHOUT_FULL.PNG
