ninux/emant/lab2/fig/not_used/S11_WITHOUT_2.4.PNG

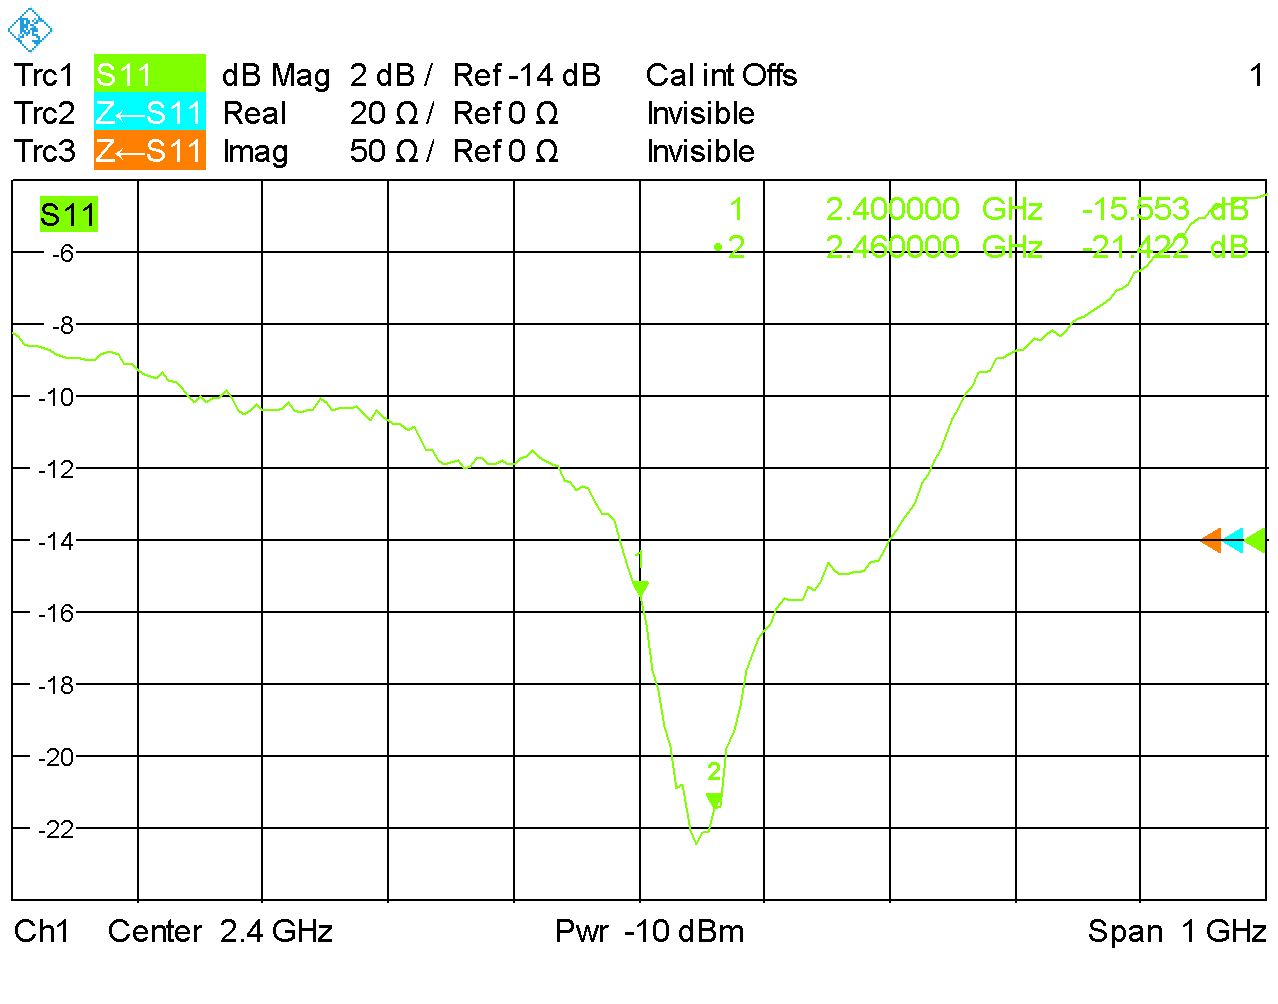
lab2/fig/not_used/S11_WITHOUT_2.4.PNG
