ninux/emant/lab2/fig/not_used/S11_WITHOUT_FULL.PNG

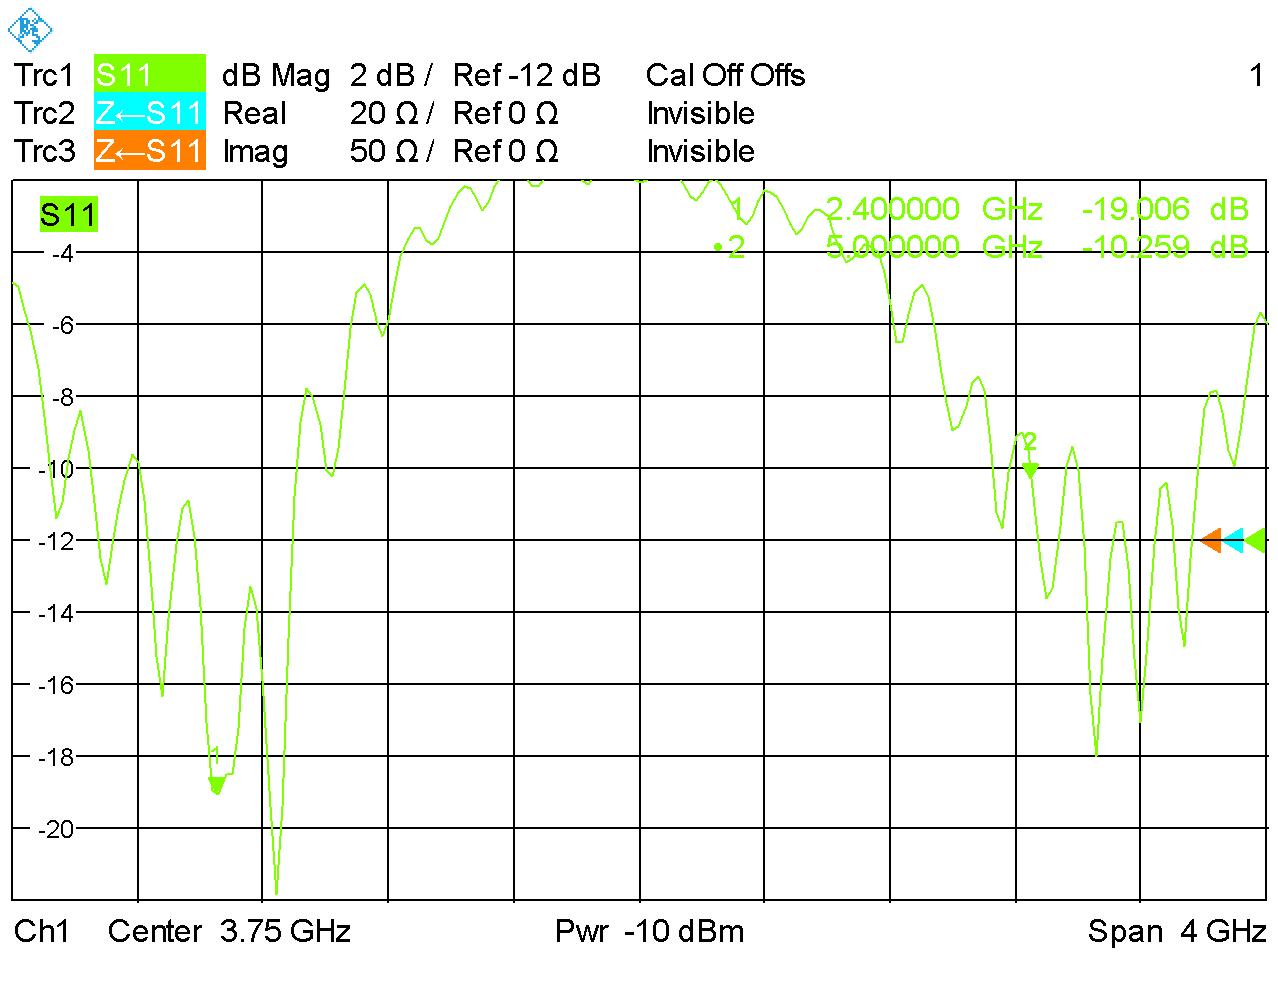
lab2/fig/not_used/S11_WITHOUT_FULL.PNG
