ninux/emant/lab2/fig/plt/abs/crazy_stuff_l4_pcb_v2c_laptop_1a_105_2ghz4_3d_farfield_eabs_xz.png

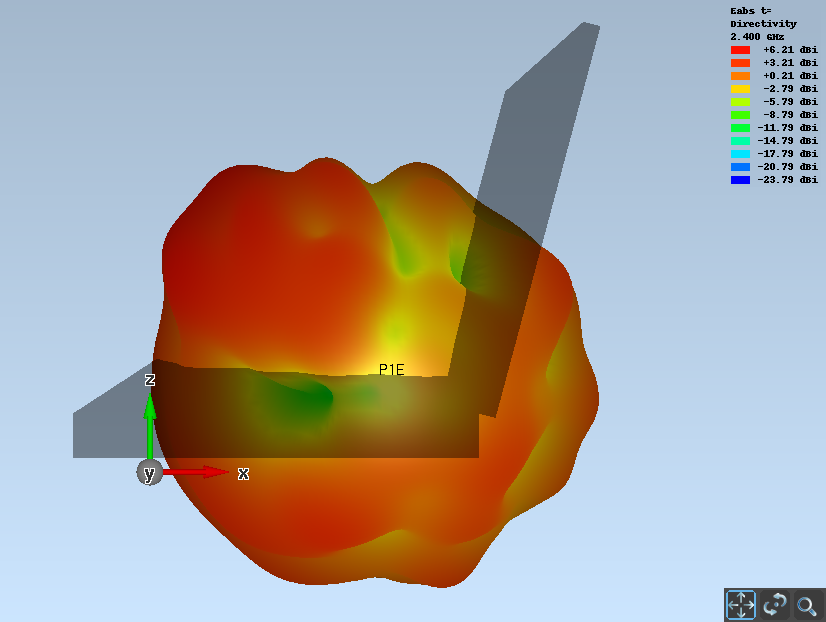
lab2/fig/plt/abs/crazy_stuff_l4_pcb_v2c_laptop_1a_105_2ghz4_3d_farfield_eabs_xz.png
