ninux/emant/lab2/fig/plt/comparison_l4_pcb_v2c_laptop_1a_105_etot_phi90_2ghz4.png

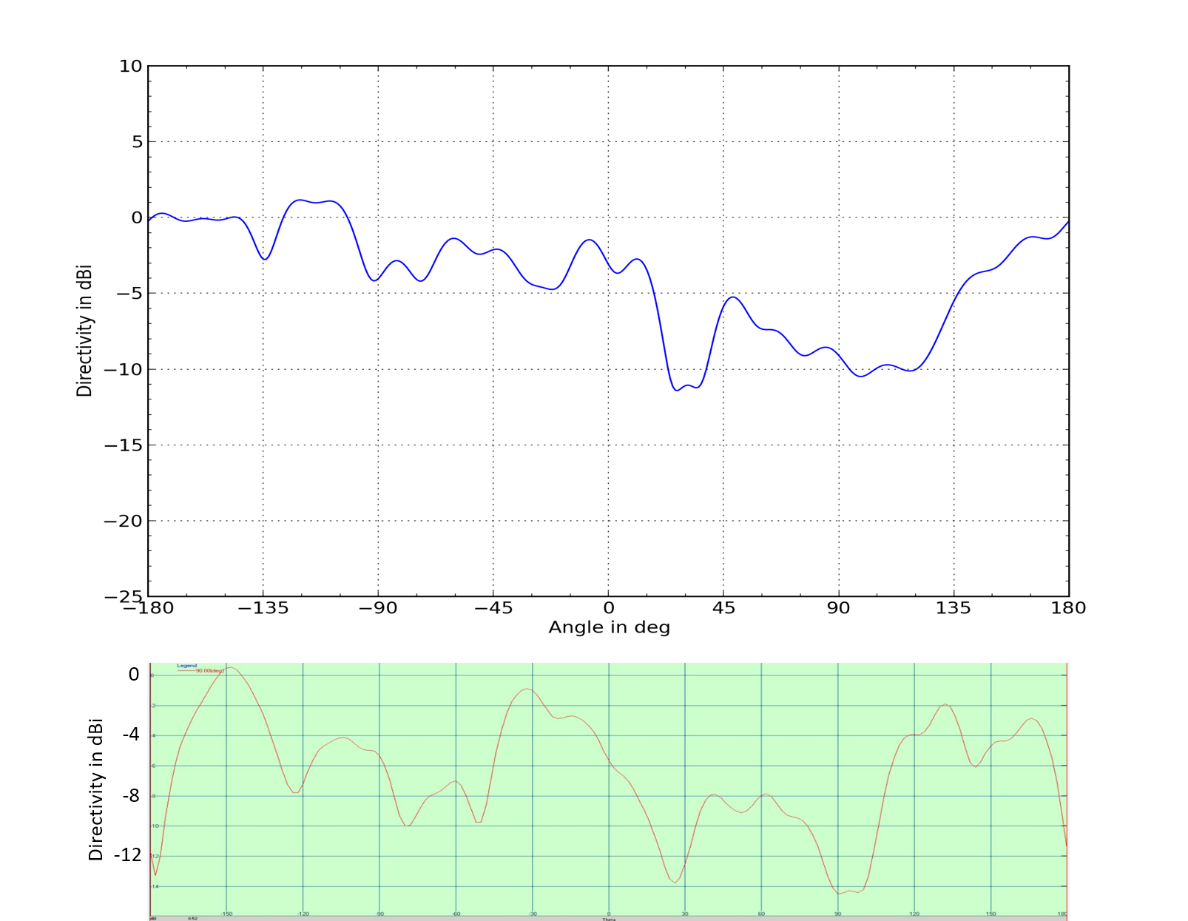
lab2/fig/plt/comparison_l4_pcb_v2c_laptop_1a_105_etot_phi90_2ghz4.png
