ninux/emant/lab2/fig/plt/crazy_stuff_l2_2d_eabs.png

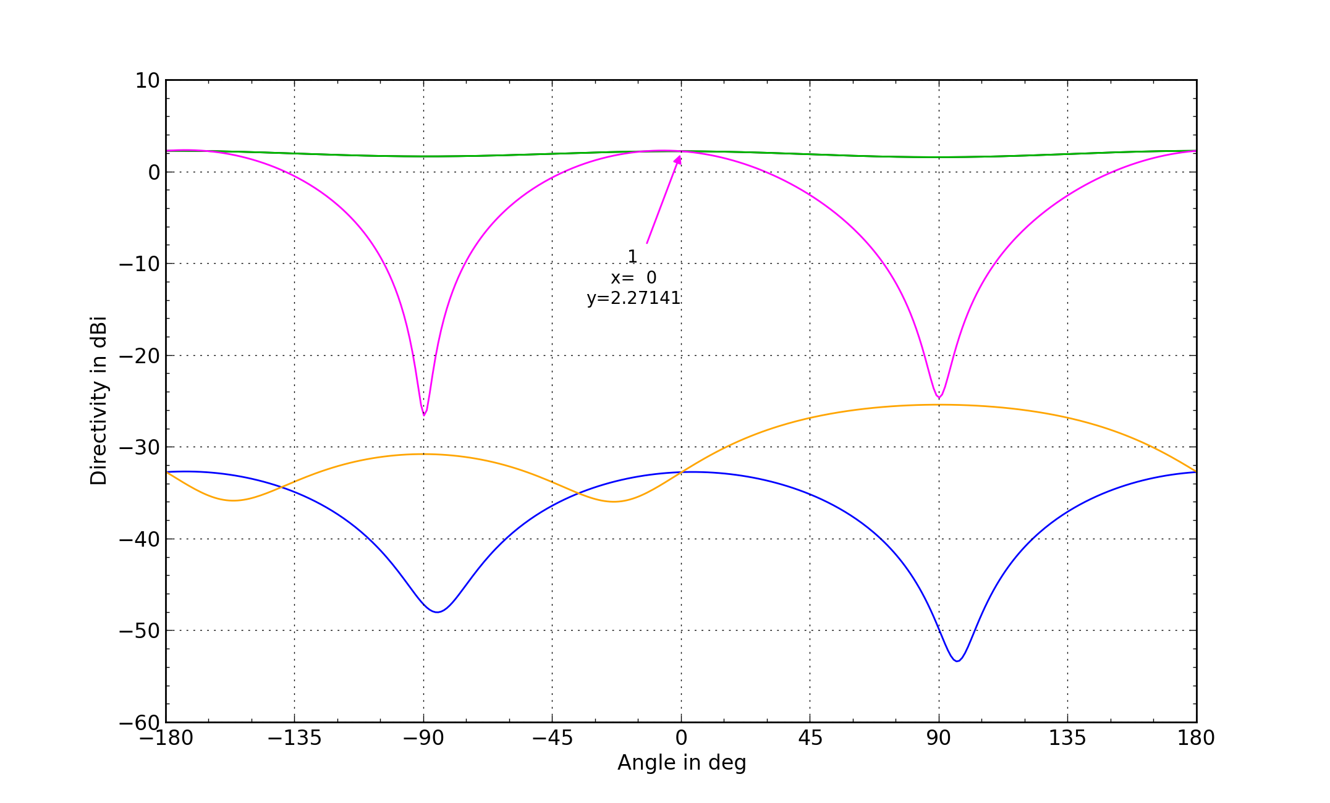
lab2/fig/plt/crazy_stuff_l2_2d_eabs.png
