ninux/emant/lab2/fig/plt/crazy_stuff_l4_pcb_v2c_laptop_1a_105_2ghz4_eabs_phi90.png

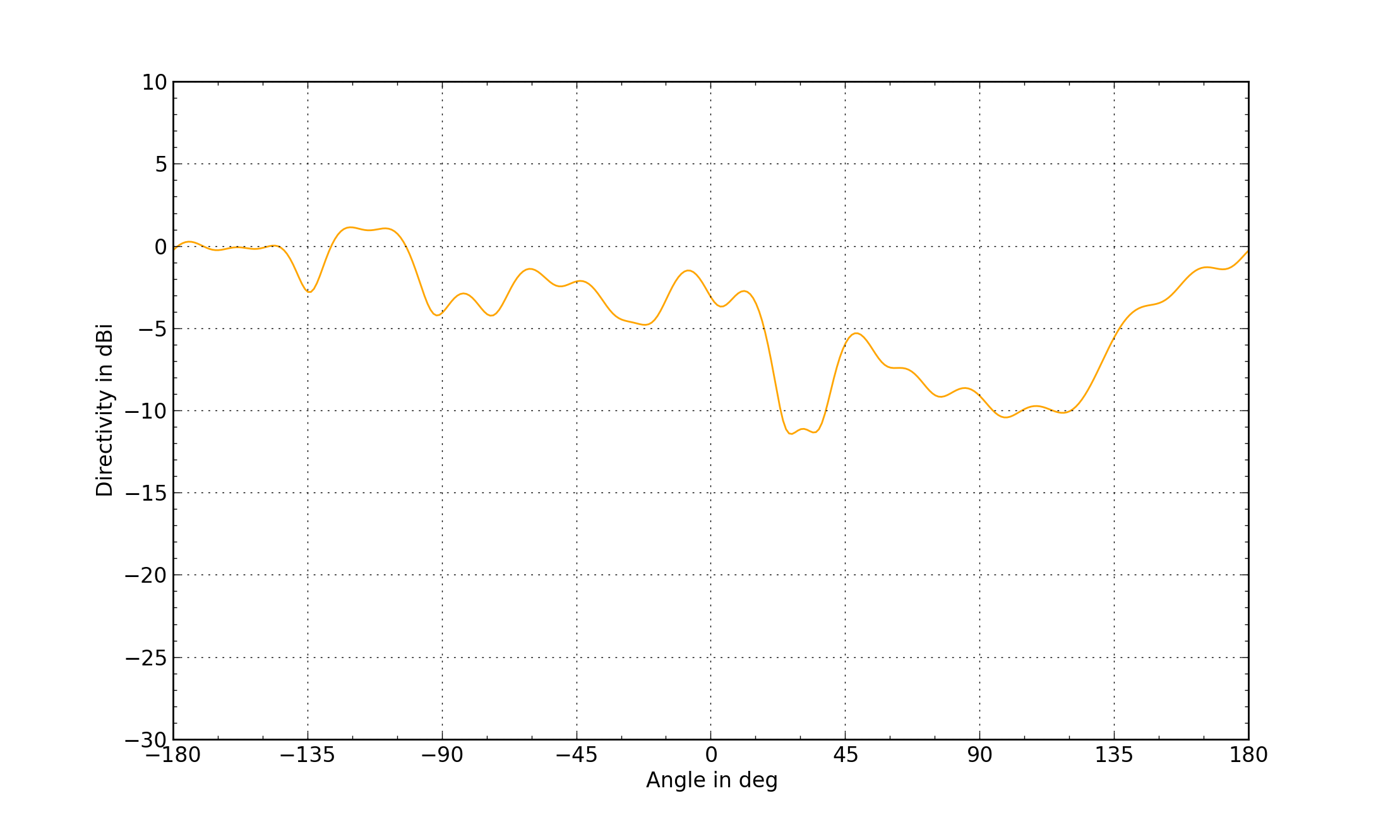
lab2/fig/plt/crazy_stuff_l4_pcb_v2c_laptop_1a_105_2ghz4_eabs_phi90.png
