ninux/emant/lab2/fig/plt/DSC_1373.JPG

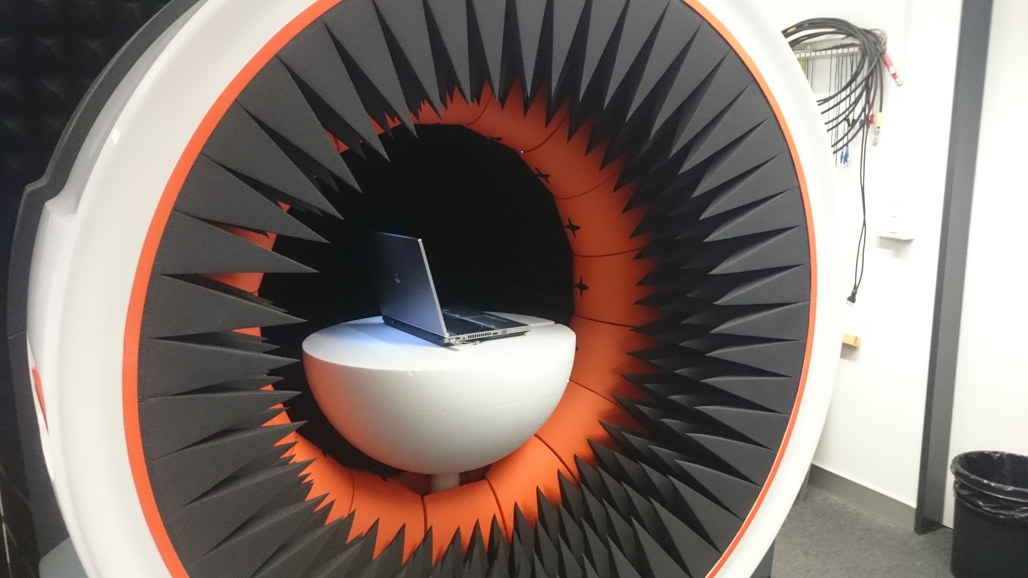
lab2/fig/plt/DSC_1373.JPG
