ninux/emant/lab2/fig/plt/IMG_20170518_182847.jpg

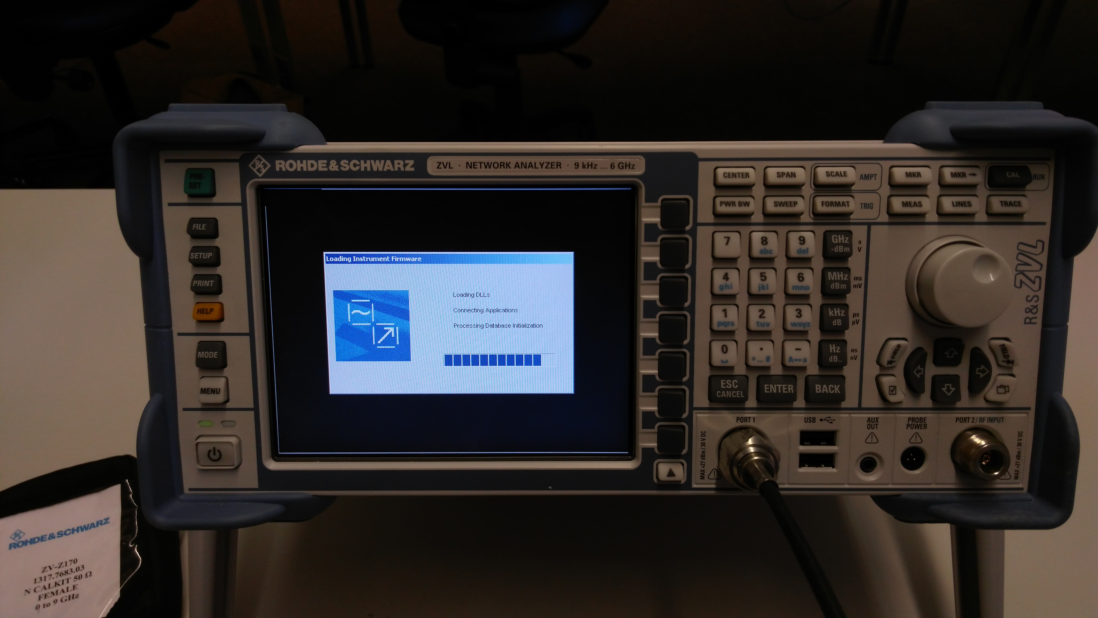
lab2/fig/plt/IMG_20170518_182847.jpg
