ninux/emant/lab2/fig/plt/IMG_20170518_182855.jpg

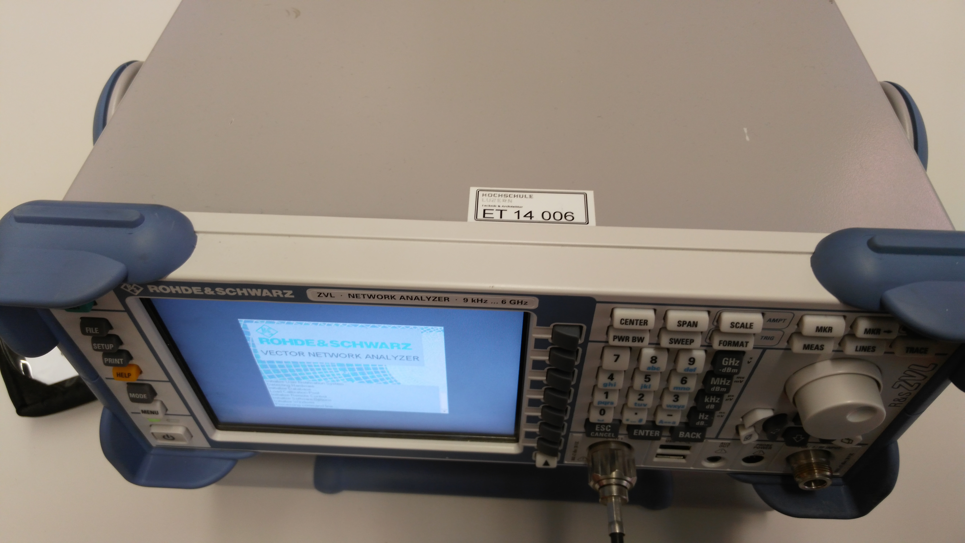
lab2/fig/plt/IMG_20170518_182855.jpg
