ninux/emant/lab2/fig/plt/IMG_20170518_182909.jpg

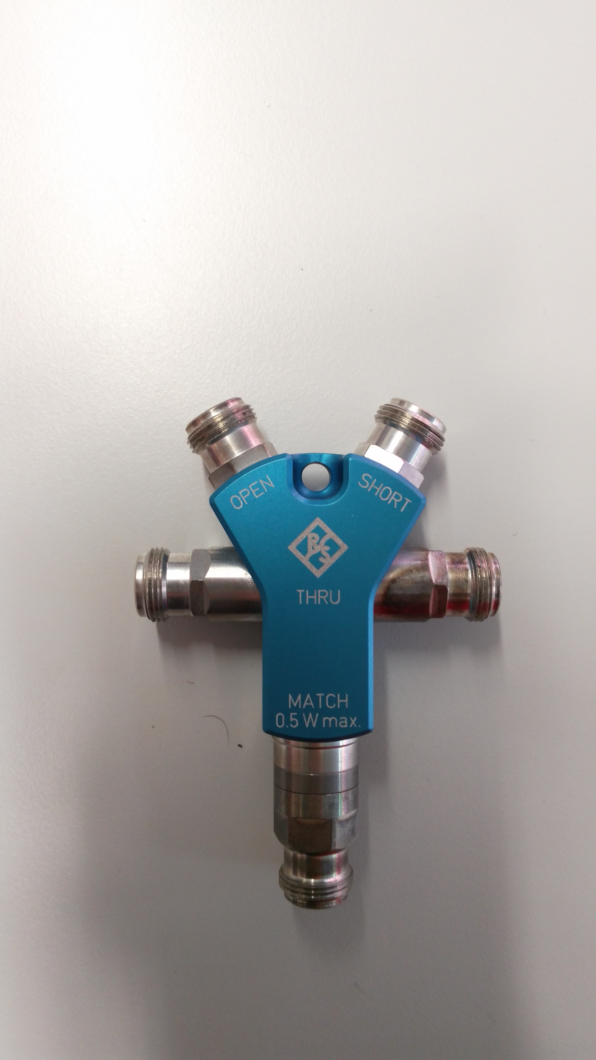
lab2/fig/plt/IMG_20170518_182909.jpg
