ninux/emant/lab2/fig/plt/IMG_20170518_183027.jpg

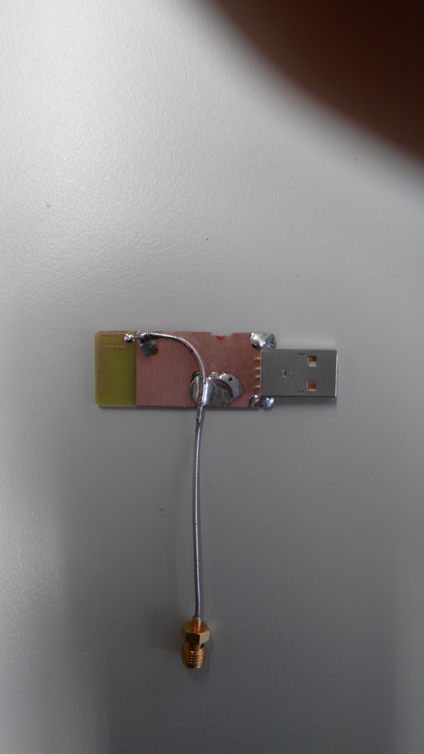
lab2/fig/plt/IMG_20170518_183027.jpg
