ninux/emant/lab2/fig/plt/IMG_20170518_183036.jpg

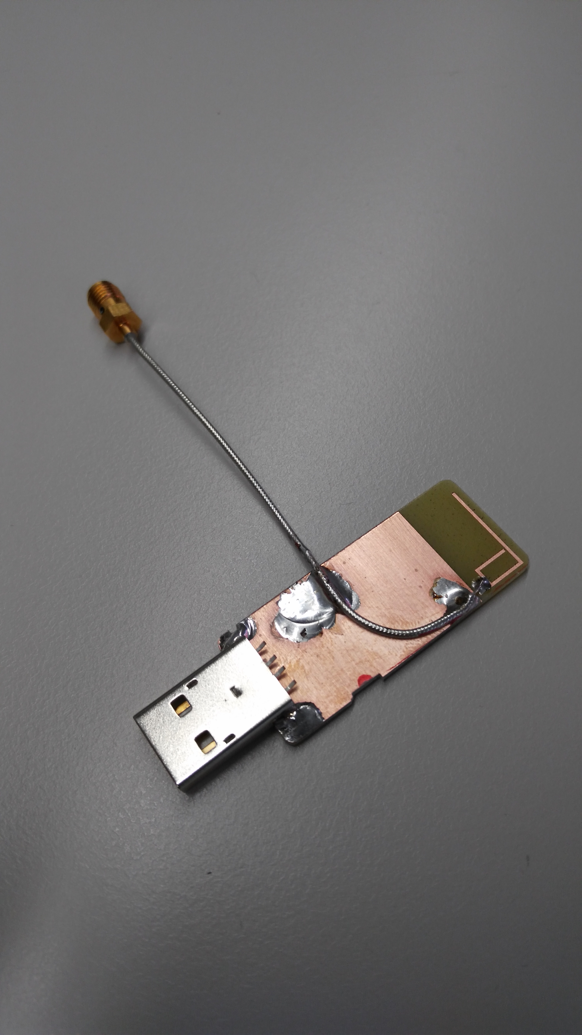
lab2/fig/plt/IMG_20170518_183036.jpg
