ninux/emant/lab2/fig/plt/IMG_20170518_183047.jpg

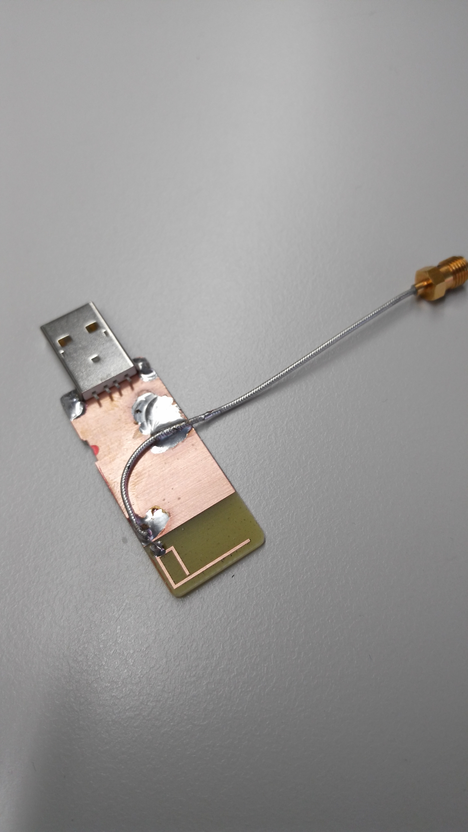
lab2/fig/plt/IMG_20170518_183047.jpg
