ninux/emant/lab2/fig/plt/IMG_20170518_183112.jpg

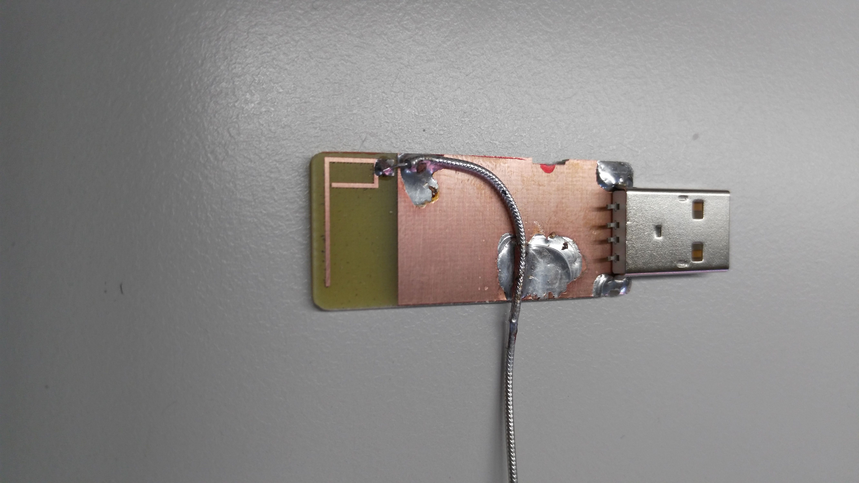
lab2/fig/plt/IMG_20170518_183112.jpg
