ninux/emant/lab2/fig/plt/IMG_20170518_183452.jpg

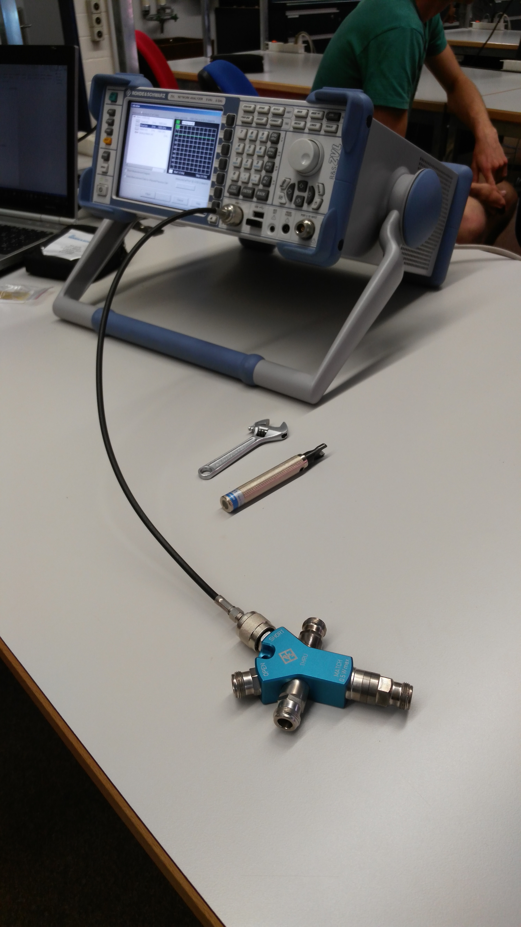
lab2/fig/plt/IMG_20170518_183452.jpg
