ninux/emant/lab2/fig/plt/IMG_20170518_183504.jpg

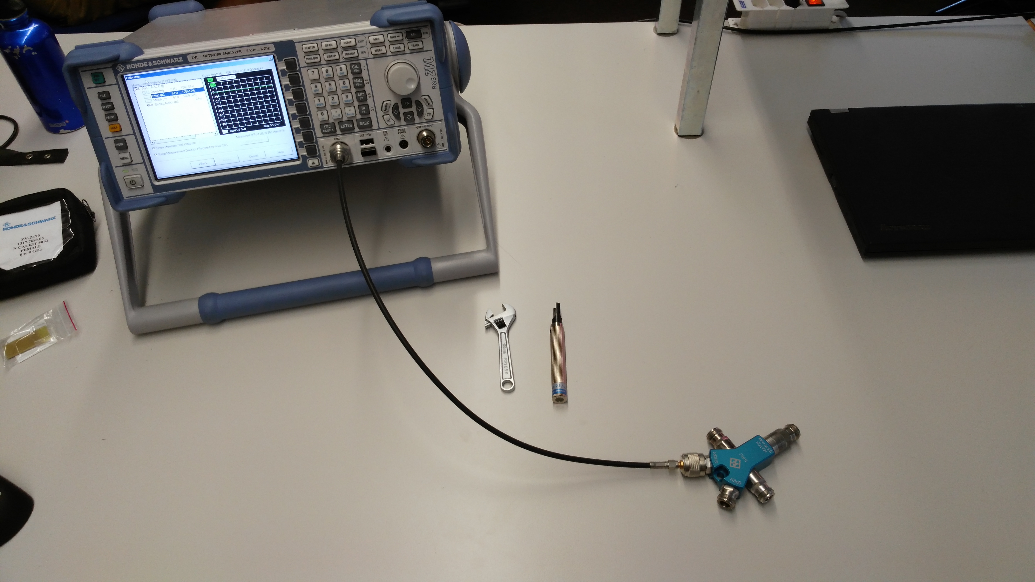
lab2/fig/plt/IMG_20170518_183504.jpg
