ninux/emant/lab2/fig/plt/LaptopimStarLab.JPG

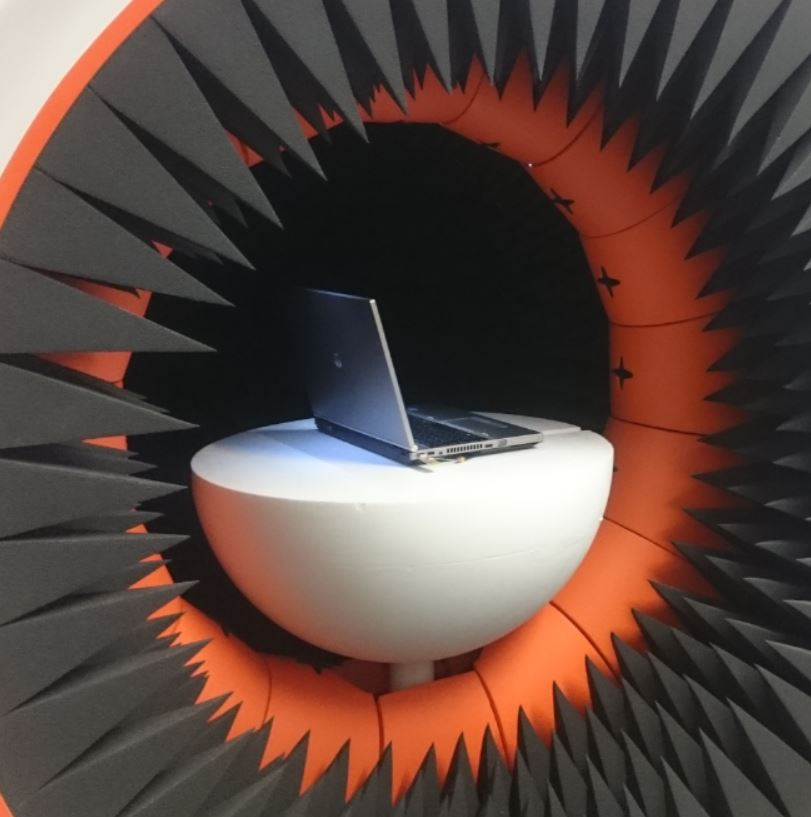
lab2/fig/plt/LaptopimStarLab.JPG
