ninux/emant/lab2/Version1/crazy_stuff_l2_3d_eabs.png

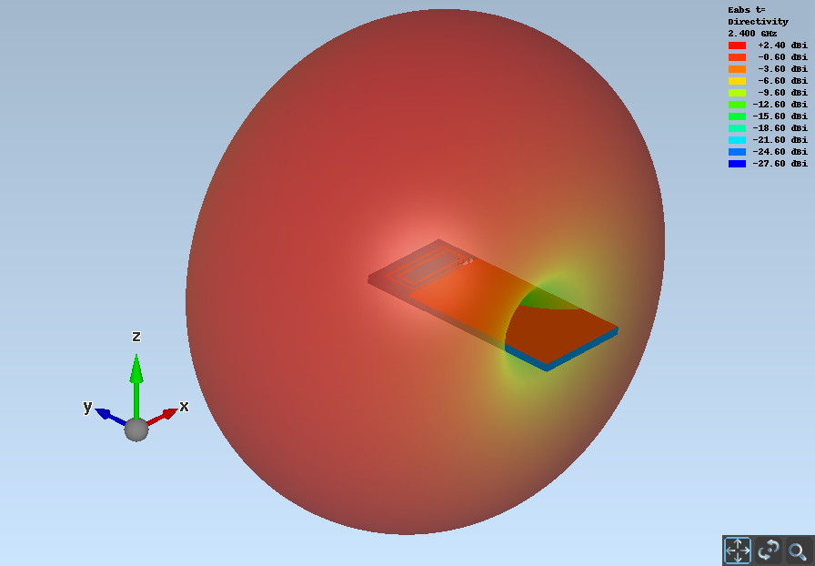
lab2/Version1/crazy_stuff_l2_3d_eabs.png
