ninux/emant/lab2/Version1/crazy_stuff_l2_3d_ephi.png

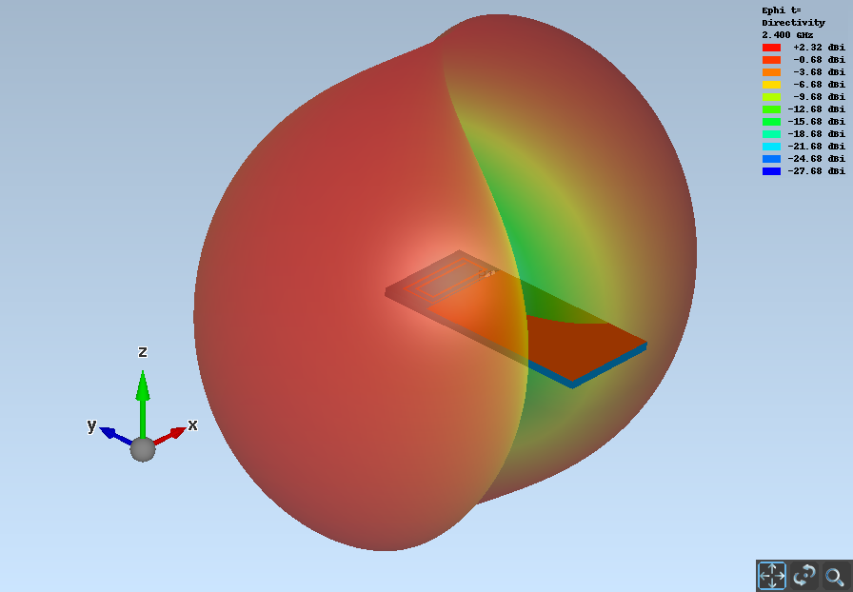
lab2/Version1/crazy_stuff_l2_3d_ephi.png
