ninux/emant/lab2/Version1/crazy_stuff_l2_3d_etheta.png

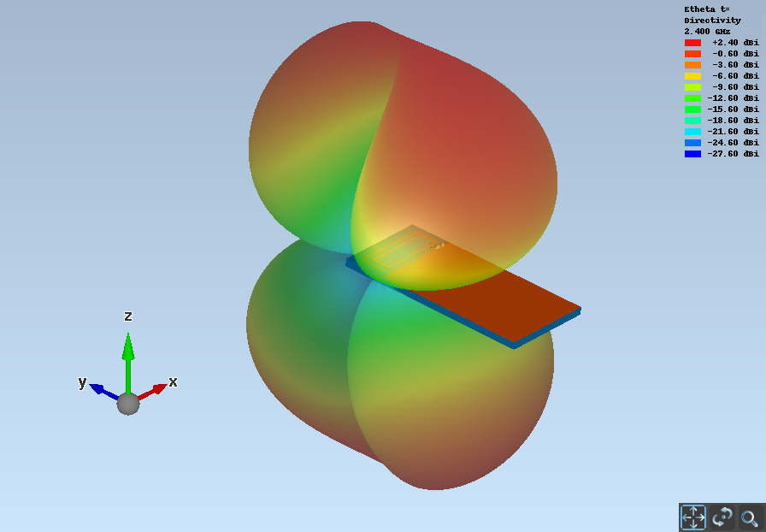
lab2/Version1/crazy_stuff_l2_3d_etheta.png
