ninux/emant/lab2/Version1/crazy_stuff_l2_s11.png

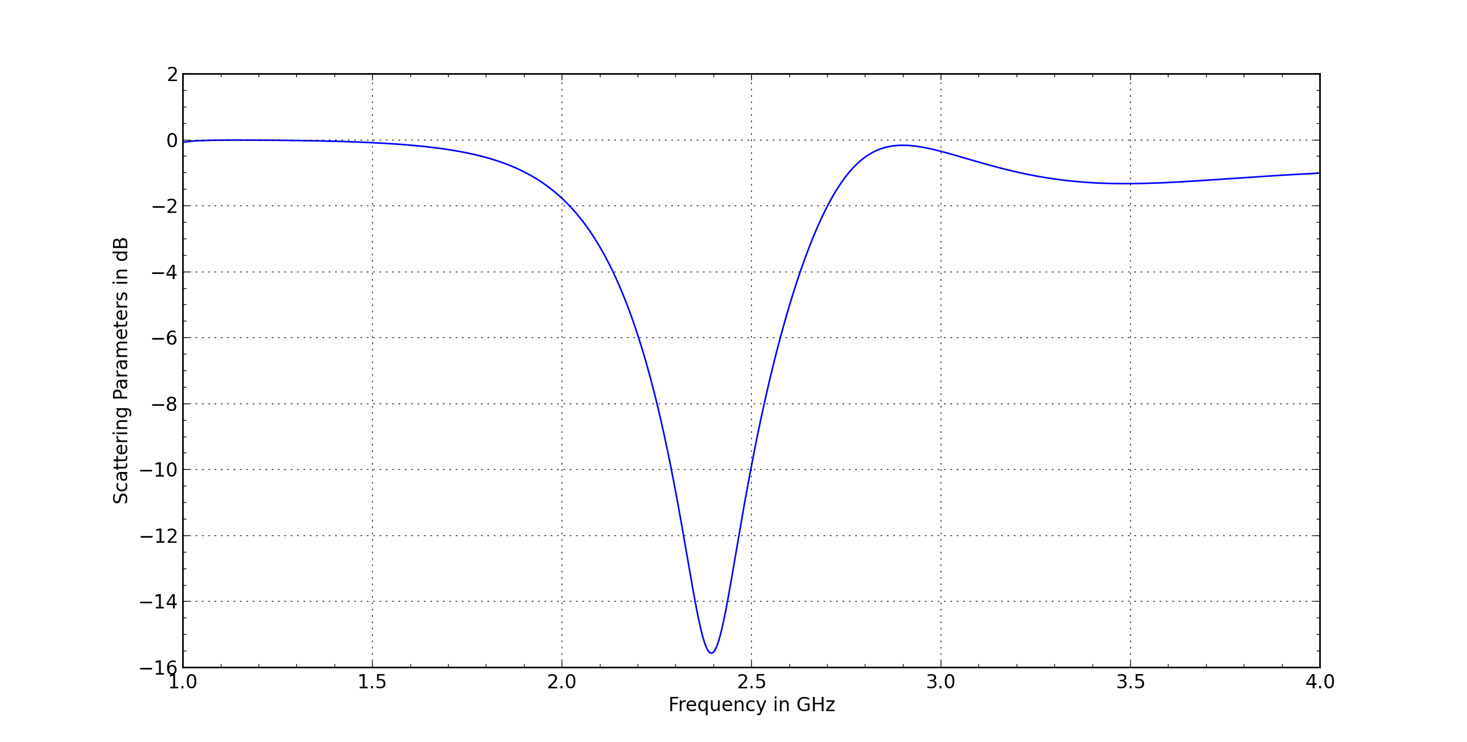
lab2/Version1/crazy_stuff_l2_s11.png
