ninux/emant/lab2/Version1/crazy_stuff_l2_z.png

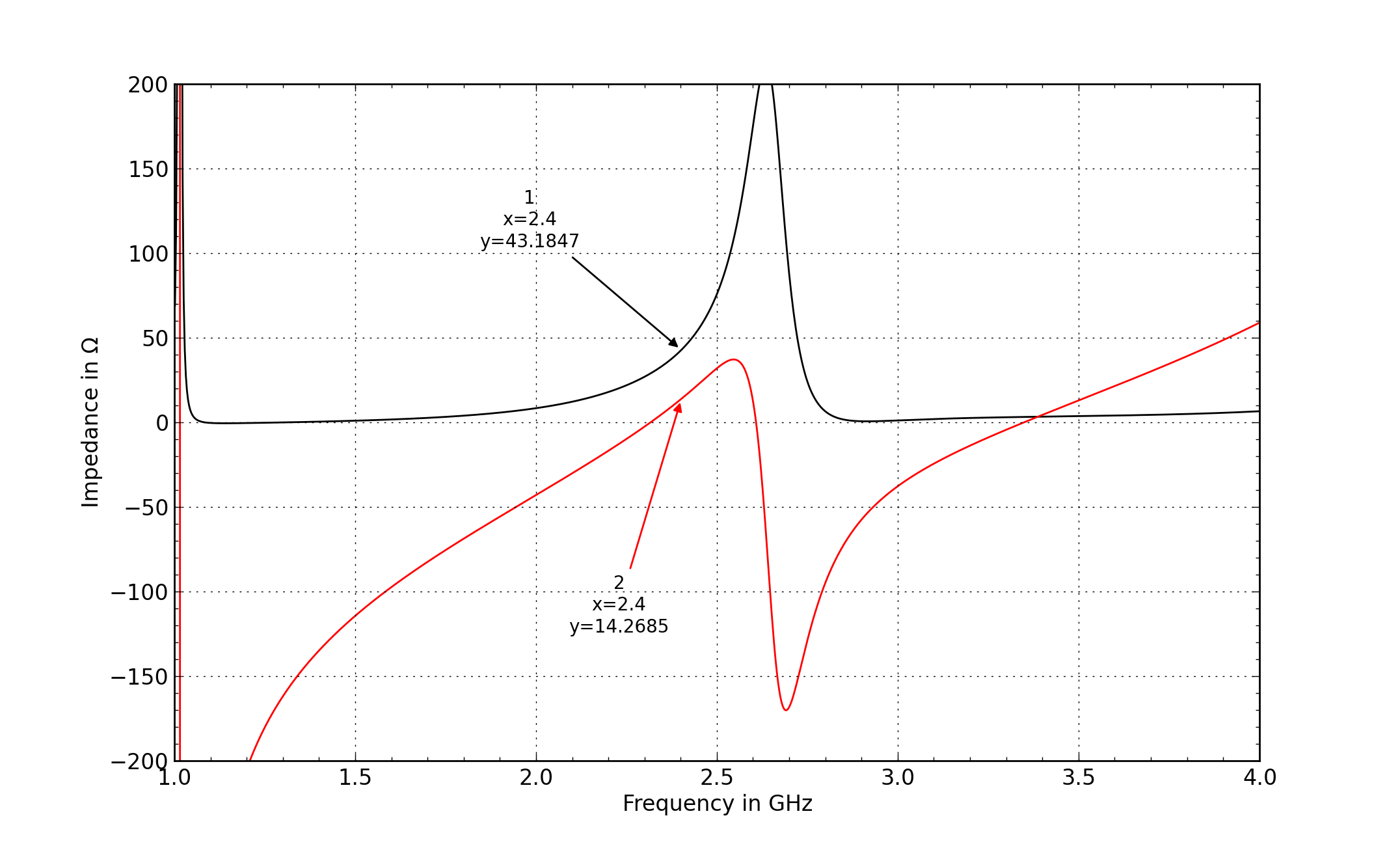
lab2/Version1/crazy_stuff_l2_z.png
