ninux/emant/lab2/Version1/Messung_version1/db.png

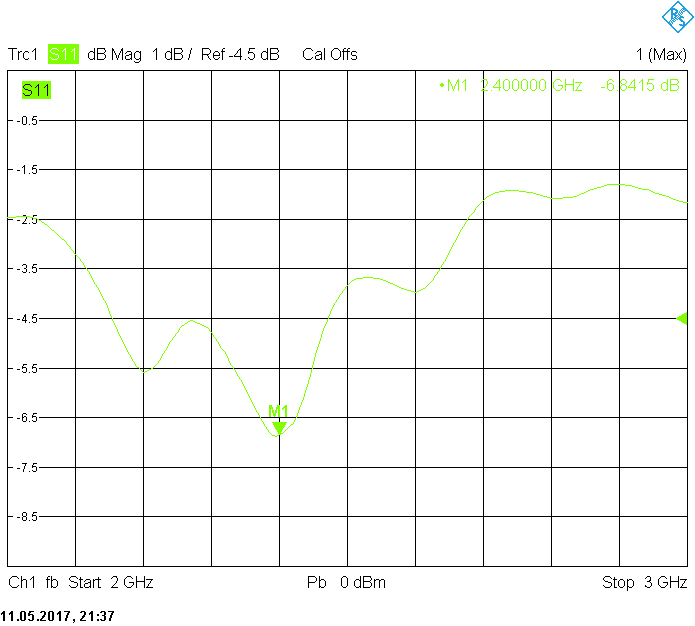
lab2/Version1/Messung_version1/db.png
