ninux/emant/lab2/Version1/Messung_version1/imag.png

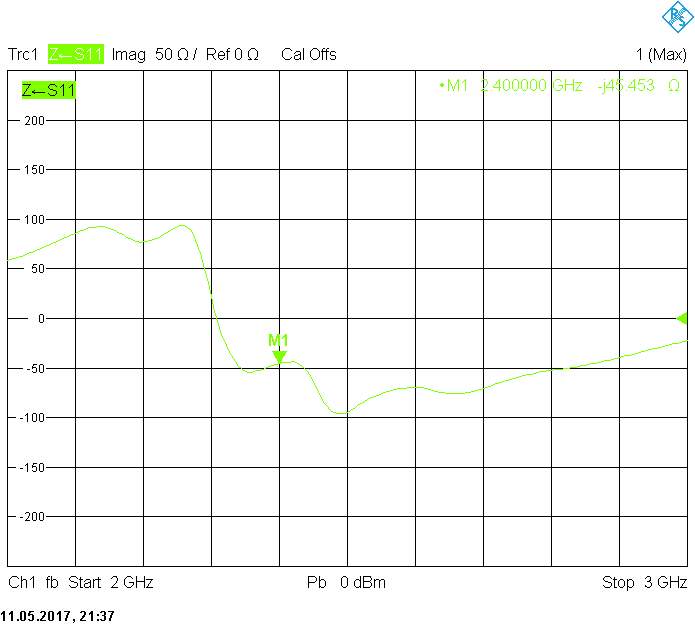
lab2/Version1/Messung_version1/imag.png
