ninux/emant/lab2/Version1/Messung_version1/real.png

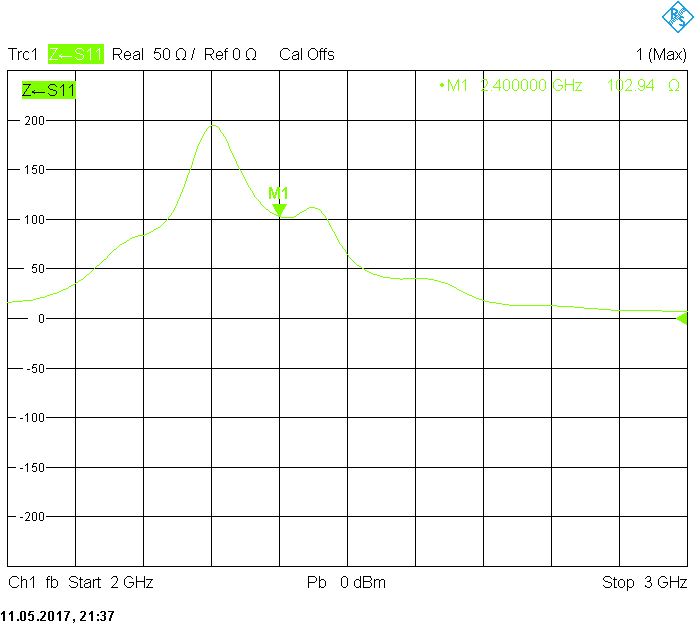
lab2/Version1/Messung_version1/real.png
