ninux/emant/lab1/ninux/rep/tex/experimental/setup.tex

\subsection{Messaufbau}

\todo{Messaufbau darlegen}
