ninux/emant/lab1/ninux/rep/tex/experimental/experimental.tex

\section{Experimentelles}

%\todo{Dieser Teil enthält die Liste der verwendeten Geräte, der
%	Versuchsaufbau, allfällig verwendete Daten, Grafiken und
%	Berechnungen und Simulationen für die Versuchsvorbereitung
%	(Messerwartung), Versuchsablauf in Prosa, sodass ein
%	Student / Studentin den Versuch wiederholen könnte.}

\input{tex/experimental/calculation}
\input{tex/experimental/simulation}
\input{tex/experimental/measurements}
%\input{tex/experimental/tools}
%\input{tex/experimental/setup}
