ninux/emant/lab1/ninux/rep/tex/results/results.tex

\section{Resultate}

%\todo{Erreichte Messergebnisse, Antworten auf allfällige
%	Fragestellungen, die mit Hilfe durchgeführter Messungen
%	hergeleitet werden.}

Die Berechnungen des gewünschten Monopols konnten durchgeführt und
ein entsprechendes Simulationsmodell erstellt werden, welches aus
einem Stab, einer Groundplane und einer Quelle besteht.

Das erstellte Simulationsmodell konnte simuliert werden und als
reales Antennenmodell realisiert werden mittels eines Drahtes,
einer Kupferplatte und einem SMA Stecker als Einspeisung.

Das erstellte Modell konnte verwendet werden zur Messung der
Reflexion und Impedanz mittels eines Vector-Network Analyzer
sowie zur Messung der Abstrahlung mittels des StarLab.

Die Ergebnisse der durchgeführten Simulationen und Messungen
zeigen, dass die wesentliche Eigenschaften keine signifikanten
Abweichungen zwischen Simulation und Messung zeigen.
