ninux/emant/lab1/ninux/rep/tex/experimental/tools.tex

\subsection{Messgeräte}

\todo{Liste der verwndeten Messgeräte aufführen}
