ninux/emant/(commit log)

2017-05-14 added initial status
    [GERBER_crazy_stuff_l2_Copper.gbr, GERBER_crazy_stuff_l2_PCB.gbr, crazy_stuff_l4_pcb_v2c_Copper.gbr, crazy_stuff_l4_pcb_v2c_PCB.gbr]
2017-05-18 Fotos der Messungen Design2 hinzugefügt
